tino7902/tablero-ajedrez-inteligente/software-docs/comandos.md

# Comandos: referencia rápida

Todos los comandos corren desde `tablero/` (ahí vive `pyproject.toml`), salvo que se
indique lo contrario. "Raspberry" significa por SSH, con el overlay `piscreen` activado
(ver [`pantalla.md`](./pantalla.md)); "notebook" significa cualquier máquina de
escritorio, sin hardware del tablero.

## Setup

```bash
cd tablero
uv sync              # instala/sincroniza dependencias en .venv
uv add <paquete>      # agrega una dependencia de runtime
uv add --dev <paquete> # agrega una dependencia de desarrollo (ej. pytest)
```

Corre en Raspberry o notebook por igual. Detalle de por qué `pygame` necesita
`uv sync --reinstall-package pygame` la primera vez en la Raspberry (compila desde fuente
contra el SDL2 del sistema): ver [`pantalla.md`](./pantalla.md#instalación-de-pygame).

## Tests

```bash
uv run pytest -v      # toda la suite
```

Corre en notebook o Raspberry. Solo `test_motor.py` necesita algo especial (el binario
`stockfish` en el `PATH`, y se saltea solo si no está); el resto —`test_logica.py`,
`test_eventos.py`, `test_reloj.py`, `test_notacion.py`, `test_partida.py`,
`test_registro.py`, `test_matriz.py`— no requiere nada. `test_sensores.py` está vacío todavía. Detalle
completo: [`testing.md`](./testing.md).

## Simulación de partida (terminal, sin hardware)

```bash
uv run python -m tablero.simulacion              # pregunta notación y minutos
uv run simulacion --notacion es --minutos 3      # sin preguntas
uv run simulacion --sin-registro                 # sin escribir en registros/
uv run simulacion --magnus facil --color negras  # contra Magnus, sin límite (necesita stockfish)
```

Corre en notebook o Raspberry, no toca `io/`. Se tipea un movimiento y el programa responde
si el tablero lo aceptaría o lo bloquearía, con el reloj corriendo y la regla de las dos
condiciones (movimiento legal + botón del reloj). Comandos completos y ejemplos:
[`simulacion.md`](./simulacion.md).

Cada partida queda registrada en `tablero/registros/` (PGN de las últimas 15, log detallado
de las últimas 5, ver [`registro.md`](./registro.md)):

```bash
cat tablero/registros/partidas/*.pgn      # PGN multi-partida, se abre en cualquier visor
cat tablero/registros/detalle/*.log       # qué intentó cada jugador, cuándo y con qué reloj
```

## Entry point del proyecto

```bash
uv run tablero               # ejecuta tablero:main
uv run python -m tablero     # forma alternativa, mismo resultado
```

## Scripts de `io/` (pantalla táctil)

Estos sí dependen de hardware o de un modo específico — ver la columna "Dónde corre".
**Regla del proyecto**: Claude Code nunca ejecuta nada de esto por su cuenta (ni siquiera
como "chequeo de sintaxis"), siempre le da a Tino el comando exacto para que lo corra él
(por SSH en la Raspberry, o localmente en su notebook para el modo ventana de `menus.py`).

| Comando | Qué hace | Dónde corre | Variables de entorno relevantes |
|---|---|---|---|
| `uv run python -m tablero.io.pantalla` | Corre `probar_boton()`: dibuja un botón de prueba y loguea cada evento de touch (`FINGERDOWN`/`MOUSEBUTTONDOWN`), aplicando calibración si existe. `Ctrl+C` para salir. | Pensado para Raspberry, pero también corre en notebook con la variable de abajo (útil para revisar el layout del botón con mouse). | `TABLERO_PANTALLA_VENTANA=1` — ver más abajo. |
| `uv run python -m tablero.io.calibracion_touch` | Corre `ejecutar_calibracion()`: muestra 5 cruces, pide tocarlas en orden, ajusta una transformación afín por mínimos cuadrados y la guarda en `calibracion_touch.json`. | Solo tiene sentido en la Raspberry — calibrar con mouse en una ventana da una transformación inútil (no hay touch real que corregir). | `TABLERO_PANTALLA_VENTANA=1` evita el crash de `kmsdrm not available` si se corre en notebook, pero no lo hace útil. |
| `uv run python -m tablero.io.menus` | Corre `ejecutar_menus()`: navega las 6 pantallas de menú/juego de los bocetos (ver [`menus.md`](./menus.md)), logueando cada botón tocado. `Ctrl+C` para salir. | Raspberry (comportamiento default) **o** notebook, con la variable de abajo — este es el caso de uso principal del modo ventana. | `TABLERO_PANTALLA_VENTANA=1` — ver más abajo. |

`TABLERO_PANTALLA_VENTANA=1`: evita que `io/_sdl.py` fuerce `SDL_VIDEODRIVER=kmsdrm` +
`SDL_NOMOUSE=1` (el backend que busca el panel físico vía DRM/KMS). Con la variable seteada,
`pygame` abre una ventana normal de escritorio de 480×320 y el mouse queda habilitado, en
vez de fallar con `pygame.error: kmsdrm not available` al no encontrar el dispositivo DRM
del panel. Sin la variable, los tres scripts se comportan como si corrieran en la
Raspberry. Detalle de por qué esto vive centralizado en `io/_sdl.py` y no repetido en cada
archivo: [`menus.md`](./menus.md#modo-ventana-testear-sin-la-raspberry).

Ejemplos completos:

```bash
# Por SSH, en la Raspberry:
cd tablero && uv run python -m tablero.io.menus

# En el notebook, sin la Raspberry, para iterar el diseño visual:
cd tablero && env TABLERO_PANTALLA_VENTANA=1 uv run python -m tablero.io.menus
```

## Scripts de `io/` (sensores y LEDs)

Solo corren en la Raspberry, por SSH, desde `tablero/`. Misma regla que arriba: Claude Code nunca
los ejecuta, le da a Tino el comando. Armado y prueba de la matriz:
`hardware-docs/matriz-hall-nano.md`; pruebas desde la Pi: "Cómo probarlo" en
[`sensores.md`](./sensores.md#matriz).

> **Matriz de sensores (v3).** `medir`, `matriz`, `calibrar` y `mapear` le piden cada lectura al
> Arduino Nano por USB serie: el Nano tiene que estar enchufado a la Pi con el firmware cargado, y
> el usuario en el grupo `dialout`. Cada comando tarda ~2 s en arrancar (abrir el puerto resetea
> el Nano). Primera vez, problemas de conexión y el puerto (`NANO_PUERTO`): "Cómo probarlo" en
> [`sensores.md`](./sensores.md#matriz).

| Comando | Qué hace | Detalle |
|---|---|---|
| `uv run python -m tablero.io.sensores` (o `... botones`) | Loguea cada presión de los botones del reloj | [`sensores.md`](./sensores.md) |
| `uv run python -m tablero.io.sensores medir F0` | Deja una fila fija para medir tensiones con el multímetro y muestra las columnas y su nivel (`ADC`) en vivo (también acepta una casilla: `medir e4`; la fila va con F mayúscula) | [`sensores.md`](./sensores.md#medir) |
| `uv run python -m tablero.io.sensores matriz` | Matriz cruda y tablero mapeado, en vivo | [`sensores.md`](./sensores.md#matriz-en-vivo) |
| `uv run python -m tablero.io.sensores calibrar` | Mide la espera de encendido de los Hall y el antirrebote, con los LEDs mostrando lo que detectan (sudo; `--sin-leds` sin ellos) | [`sensores.md`](./sensores.md#calibrar) |
| `uv run python -m tablero.io.sensores mapear` | Genera `CASILLA_DE_CELDA_HALL` (las 64 casillas) | [`sensores.md`](./sensores.md#mapear) |
| `uv run python -m tablero.io.leds todos` / `recorrer` / `esquinas` / `calibrar` / `verificar` | Pruebas de la tira de LEDs (se relanza con `sudo`) | [`leds.md`](./leds.md) |
| `uv run python -m tablero.io.prueba_tablero leds` / `recorrido` / `espejo` / `inicial` | Sensores y LEDs juntos: asociar LEDs, verificar las 64 casillas, espejo en vivo, posición inicial (se relanza con `sudo`) | [`prueba-tablero.md`](./prueba-tablero.md) |
| `uv run python -m tablero.io.juego` (`--minutos N`, `--fen FEN`, `--sin-leds`, `--sin-registro`, `-v`) | Partida en el tablero físico: matriz, botones del reloj y LEDs; la jugada cuenta al apretar el reloj (se relanza con `sudo`, salvo con `--sin-leds`) | [`juego.md`](./juego.md) |
| `uv run python -m tablero.io.juego --magnus {facil,medio,dificil}` (`--color {blancas,negras,aleatorio}`) | Lo mismo contra Magnus (Stockfish), sin límite de tiempo: su jugada la hacés vos en el tablero y la confirmás con cualquier botón. Necesita `stockfish` (`sudo apt install stockfish`) | [`juego.md`](./juego.md#contra-magnus---magnus) |
| `uv run python -m tablero.io.sensores_reed matriz` / `calibrar` | La versión anterior, con reed switches | [`sensores-reed.md`](./sensores-reed.md) |
| `uv run python -m tablero.io.menus_gpio` | La interfaz completa con los botones físicos del reloj | [`menus.md`](./menus.md) |

## Firmware del Arduino Nano

Desde la **raíz del repo** (no desde `tablero/`), en la notebook. Compilar sirve para chequear el
firmware sin el Nano, y Claude Code lo puede correr; subirlo y abrir el monitor necesitan el Nano
enchufado, así que los corre Tino. Detalle, protocolo y prueba con el Nano suelto en
[`firmware-nano.md`](./firmware-nano.md).

| Comando | Qué hace |
|---|---|
| `arduino-cli compile --fqbn arduino:avr:nano:cpu=atmega328 firmware/matriz-nano` | Compila el firmware (agregar `--build-property "compiler.cpp.extra_flags=-DPLAN_B=1"` para el plan B) |
| `arduino-cli compile --upload -p /dev/ttyUSB0 --fqbn arduino:avr:nano:cpu=atmega328 firmware/matriz-nano` | Compila y lo sube al Nano (si da `not in sync`, el Nano tiene el bootloader viejo: `cpu=atmega328old`) |
| `arduino-cli monitor -p /dev/ttyUSB0 -c baudrate=115200` | Monitor serie, para escribirle comandos (`?`, `L`, `F 0`, `C`, `X`, `A`, `V`) |
| `arduino-cli board list` | En qué puerto quedó el Nano (`/dev/ttyUSB0` en los clones con CH340, si no `/dev/ttyACM0`) |

## Ver también

- [`pantalla.md`](./pantalla.md) — overlay `piscreen`, instalación de `pygame`, calibración
  táctil.
- [`menus.md`](./menus.md) — grafo de navegación de `io/menus.py` y el modo ventana.
- [`testing.md`](./testing.md) — qué cubre cada archivo de test.
- [`simulacion.md`](./simulacion.md) — modo de prueba de la lógica por terminal.
- [`vs-magnus.md`](./vs-magnus.md) — el modo contra Stockfish.
- [`pendiente-pi.md`](./pendiente-pi.md) — lo que falta probar en la Pi y cómo.
- [`arranque-automatico.md`](./arranque-automatico.md) — el servicio de systemd que abre el
  menú al prender la Pi, y cómo pararlo para probar otra cosa por SSH.
- [`registro.md`](./registro.md) — dónde y cómo quedan registradas las partidas.
