tino7902/tablero-ajedrez-inteligente/software-docs/leds.md

# `io/leds.py`

Controla los 64 LEDs WS2812B del tablero, uno por casilla, con `rpi-ws281x`. Hasta el
2026-10-22 había además un LED de sacrificio al principio de la tira (ver
`hardware-docs/componentes.md`); ese día se quemó, la señal pasó a entrar directo al primer
LED de las casillas (el de h8) y el mapeo se corrió en −1. **Probado en el prototipo** (2026-10-18):
los 64 LEDs funcionan y `LED_DE_CASILLA` ya está generado con `prueba_tablero leds` (ver
[`prueba-tablero.md`](./prueba-tablero.md)). La tira se alimenta, por ahora, con un cargador de
celular que comparte con el Nano (ver `hardware-docs/componentes.md`).

## API

| Función/clase | Qué hace |
|---|---|
| `indice_de(casilla)` | Índice en la tira del LED de una `chess.Square`, según la tabla `LED_DE_CASILLA` |
| `TiraLeds(brillo)` | Inicializa la tira (`PixelStrip.begin()`) |
| `.encender(casilla, color)` / `.encender_indice(i, color)` | Fija el color de un LED (no se ve hasta `mostrar()`) |
| `.limpiar()` / `.mostrar()` / `.apagar()` | Todo en negro / enviar a la tira / las dos cosas |
| `formatear_led_de_casilla(tabla)` | Bloque `LED_DE_CASILLA` listo para pegar en `config.py`; lo usan `calibrar` y `prueba_tablero leds` |
| `ROJO`, `VERDE`, `AZUL`, `AMARILLO`, `BLANCO`, `APAGADO`, `BLANCO_TENUE`, `VIOLETA`, `CIAN` | Colores (`rpi_ws281x.Color`). Los últimos tres los usa `io/juego.py`: destinos posibles y la jugada de Magnus |

## Configuración (`config.py`)

| Constante | Valor | Nota |
|---|---|---|
| `LED_GPIO_BCM` | 12 | Pin físico 32. `rpi-ws281x` usa numeración **BCM**, no BOARD como `io/sensores.py` |
| `LED_CANAL_PWM` | 0 | GPIO 12 es PWM0 |
| `LED_CANTIDAD` | 64 | 65 si se vuelve a poner un LED de sacrificio |
| `LED_INDICE_SACRIFICIO` | `None` | Sin LED de sacrificio. Con uno (índice 0), `mostrar()` lo fuerza a negro antes de enviar |
| `LED_BRILLO` | 32 | Brillo global, de 0 a `LED_BRILLO_MAX` |
| `LED_BRILLO_MAX` | 191 | Tope del brillo (75 %): `TiraLeds` lo aplica aunque `--brillo` pida más, y avisa por el log |
| `LED_DE_CASILLA` | Generado el 2026-10-22 y espejado (a↔h): serpentina por columnas desde h8; corrido en −1 al sacar el LED de sacrificio | Tabla de 64 índices (`[chess.Square]`); se regenera con `calibrar` o `prueba_tablero leds` |

## Decisiones de diseño

- **Mapeo casilla → LED por tabla, no por fórmula**: `LED_DE_CASILLA[casilla]` da el índice
  en la tira, igual que las permutaciones de `io/sensores.py` para la matriz. Así no importa
  cómo se haya soldado la tira (serpentina, filas en el mismo sentido, arrancando en h8...) ni
  si algún tramo quedó salteado: se mide con `calibrar` y se pega el resultado. El valor por
  defecto supone serpentina desde a1 justo después del LED de sacrificio.
- **Brillo bajo por defecto y con tope**: 64 LEDs en blanco al 100 % consumen ~3,8 A, en el
  límite de la fuente de 5 V >4 A. Para las pruebas alcanza con 32; `--brillo` permite
  subirlo hasta `LED_BRILLO_MAX` (75 %). El tope está en `TiraLeds`, así vale para todos los
  programas. Al 75 %, el peor caso (`leds todos` en blanco) es ~2,9 A. En `juego`, en uso
  normal, lo más que se prende es la posición inicial en verde o en rojo (32 casillas de un
  solo color, ~0,5 A).
- **LED de sacrificio siempre apagado**: su único trabajo es regenerar la señal de datos a
  nivel de 5 V para el resto de la tira (alimentado a ~4,3 V por el 1N4007), así que no importa
  qué color muestre. **Sin él** (desde el 2026-10-22) los 3,3 V de GPIO 12 entran directo a un
  WS2812B alimentado a 5 V, que pide ≥ 0,7 × 5 V = 3,5 V para leer un 1: suele andar igual,
  pero queda al límite. Si la tira parpadea o muestra colores al azar, la solución es volver a
  poner un LED de sacrificio (con su 1N4007) o un adaptador de nivel (74AHCT125).

## Requisitos en la Raspberry

- **Root**: `rpi-ws281x` accede a `/dev/mem`. Se corre como el resto del proyecto,
  `uv run python -m tablero.io.leds ...` desde `tablero/`: si el proceso no es root, el
  `__main__` de `io/leds.py` se relanza con `sudo <python del .venv> -m tablero.io.leds ...`
  (en Raspberry Pi OS el usuario principal tiene sudo sin contraseña). No usar
  `sudo uv run`, que corre con el entorno de root y puede dejar archivos de root en el
  `.venv`. Un programa que importe `TiraLeds` tiene que arrancar como root o relanzarse igual
  (es lo que hacen `io/prueba_tablero.py` e `io/juego.py`).
- **Audio analógico desactivado**: el PWM de los LEDs es el mismo que el del audio. En
  `/boot/firmware/config.txt` (o `/boot/config.txt` en sistemas viejos) poner
  `dtparam=audio=off` y reiniciar. Sin esto, los LEDs parpadean con colores al azar o no
  responden.
- **GND común** entre la fuente de 5 V de los LEDs y la Raspberry.

## Cómo probarlo

Desde `tablero/`, por SSH en la Raspberry:

```bash
uv run python -m tablero.io.leds todos      # 64 casillas en rojo, verde, azul y blanco
uv run python -m tablero.io.leds recorrer   # un LED por vez, Enter para el siguiente
uv run python -m tablero.io.leds esquinas   # a1 rojo, h1 verde, a8 azul, h8 amarillo
uv run python -m tablero.io.leds calibrar   # genera LED_DE_CASILLA
uv run python -m tablero.io.leds verificar  # recorre a1, b1, ..., h8 con el mapeo
```

Orden recomendado: `todos` (¿prenden todos? ¿colores correctos, o rojo y verde invertidos?
Eso sería `strip_type` GRB/RGB), después `calibrar` y por último `verificar`/`esquinas` para
confirmar el mapeo. `Ctrl+C` apaga la tira y sale.

**Con los sensores Hall ya mapeados**, en vez de `calibrar` conviene
`uv run python -m tablero.io.prueba_tablero leds`: prende cada LED y la casilla la dicen los Hall
al poner una pieza en la casilla iluminada, sin tipear nada. Después,
`prueba_tablero recorrido` verifica LEDs y sensores juntos. Ver [`prueba-tablero.md`](./prueba-tablero.md).

### `calibrar`

Prende cada LED (1..64) en blanco y pregunta en qué casilla se ve. Se responde con el nombre
(`e4`), `-` si ese LED no cae en ninguna casilla, o `r` para volver al LED anterior si hubo un
error. No deja asignar dos LEDs a la misma casilla. Al final imprime la tupla
`LED_DE_CASILLA` lista para pegar en `config.py`, una fila de ajedrez por línea.
