tino7902/tablero-ajedrez-inteligente/hardware-docs/matriz-hall-nano.html

Tablero de ajedrez · guía de armado · hardware

# Matriz Hall con Arduino Nano

Guía para armar la detección de casillas: 64 sensores Hall A3144 en una matriz de 8 × 8, leídos por un Arduino Nano que le pasa el estado del tablero a la Raspberry Pi por USB. Un NPN por fila maneja la corriente. Reemplaza al 74HC138 y al 74HC165. Las 64 celdas ya están soldadas; esta guía cubre todo lo demás.

## Por qué se cambia

1,6 Vdaba la salida activa del 138 (tenía que ser < 0,3 V)

~200 mApuede pasar por una fila llena de piezas con las celdas como están soldadas

≈ 9 mApone un pin del Nano en la base del NPN de la fila (con 470 Ω)

5 Valimentan los Hall, en vez de 3,3 V

El 138 no podía hundir la corriente de una fila. Con el Nano, cada fila tiene un transistor que la maneja y los Hall se alimentan a 5 V. Ningún pin de la Raspberry queda conectado a la matriz: la Pi solo ve el Nano por USB.

## Materiales

Componente | Cantidad | Detalle
Arduino Nano (ATmega328P) | 1 | Original o clon. Con su cable USB (mini-USB o USB-C, según el modelo).
Transistor NPN | 8 | Uno por fila. BC337, 2N2222 o S8050. No BC547, BC548 ni 2N3904: no aguantan la corriente (ver Transistores).
Resistencia 470 Ω | 8 | Base de cada NPN.
Resistencia 10 kΩ | 8 | Entre base y GND de cada NPN (lo mantiene apagado).
Sensor Hall A3144 + diodo | 64 | Ya soldados, uno por casilla, con el diodo en el GND (ver Una celda).
Placa perforada, cable, tira de pines o zócalo para el Nano | — | Conviene montar el Nano en zócalo o tira hembra para poder sacarlo.

Salen de la placa: el 74HC138, el 74HC165 y las 8 resistencias pull-up de 10 kΩ que iban a 3,3 V. Las columnas usan las pull-ups internas del Nano.

## Esquema general

Cómo funciona: el Nano enciende una fila por vez (pone su pin en HIGH), espera 1 ms a que los Hall arranquen, lee las 8 columnas y pasa a la siguiente. Una columna en LOW es un imán sobre esa casilla. Hace ese recorrido cada vez que la Pi se lo pide (muchas veces por segundo) y le contesta la matriz por el puerto serie.

### La matriz, cable por cable

Cada punto es un Hall. Su GND llega al bus de su fila (negro) a través de un diodo; su salida va directo al cable de su columna (azul). El Vcc de los 64 Hall va al riel de 5 V (no dibujado en la grilla).

## Una fila: el driver NPN

Hay 8 iguales, uno por fila. Se pueden armar juntos en un costado de la placa, cerca del Nano.

Estado | Pin del Nano | NPN | Bus de la fila
Fila elegida | HIGH (5 V) | conduce (≈ 9 mA de base) | ≈ 0,1–0,3 V: fila encendida
Fila no elegida | LOW (0 V) | cortado | flota: fila apagada

- Por qué hasta ~200 mA: los 8 Hall de la fila consumen ~35 mA. Además, cada Hall que detecta una pieza recibe ~20 mA de los otros 7 Hall de su columna (ver Una celda), y esa corriente también baja por el NPN. Con la fila llena de piezas, como en la posición inicial, son 35 + 8 × 20 ≈ 200 mA.
- La resistencia de 470 Ω deja pasar ~9 mA del pin del Nano (su máximo recomendado es 20 mA), lo justo para saturar el NPN con 200 mA. Sin ella se quema el pin o el transistor.
- La de 10 kΩ deja el NPN apagado mientras el Nano arranca o si se desconecta.
- El emisor y la de 10 kΩ van al GND del Nano. Todos los GND del circuito son el mismo.

## Una celda: así están soldadas

Las 64 celdas ya están armadas así y no se cambian. El diodo está en el GND de cada Hall, y la salida va directo a la columna.

### Qué implica este armado

Efecto | Valor | Consecuencia
El diodo suma ~0,6–0,8 V en el GND de cada Hall | 4,3 V · 3,9 V con fila llena | Tensión de alimentación de cada Hall, por debajo de los 4,5 V que pide la hoja de datos del A3144 original. Los clones que se venden hoy suelen funcionar igual: hay que comprobarlo en la prueba.
Los otros 7 Hall de la columna le pasan corriente al que detecta | ~20 mA | En las filas apagadas, el GND de cada Hall flota y su consumo sale por un diodo interno hacia su salida, que está unida a la columna. Está dentro de lo que aguanta la salida del A3144 (~25 mA), pero obliga a usar un NPN más fuerte.
Nivel bajo de la columna con pieza | ~1,1–1,3 V | El Nano tiene garantizado leer LOW hasta 1,5 V. Si queda más alto, pasar al plan B.
Piezas fantasma | no hay | El diodo del GND impide que un Hall de una fila apagada encuentre camino a GND, así que no puede bajar la columna.

Sensor | Patas
A3144 (TO-92) | Mirando la cara plana con letras, patas hacia abajo, de izquierda a derecha: 1 Vcc · 2 GND · 3 OUT.

- Polaridad: el A3144 solo detecta el polo sur de un imán puesto contra su cara con letras. Esa cara va hacia arriba y todos los imanes, con el sur hacia abajo.
- No puentear el diodo del GND: sin él, las filas apagadas bajarían las columnas y aparecerían piezas fantasma.

## Tabla de conexiones

Cada fila y cada columna conserva el número que tenía con el 138 y el 165: el cable que iba a la salida Yk del 138 ahora es la fila Fk, y el que iba a la entrada Dk del 165 ahora es la columna Ck. Así el mapeo de casillas que ya está en el software (CASILLA_DE_CELDA_HALL) sigue valiendo. Respetar este orden.

Fila | Pin del Nano | Va a | Antes iba a

Columna | Pin del Nano | Va a | Antes iba a

Otros pines del Nano | Conexión
5V | Riel de Vcc de los 64 Hall.
GND | Emisores de los 8 NPN y las 8 resistencias de 10 kΩ de base. Cualquiera de los dos pines GND del Nano.
USB | A un puerto USB de la Raspberry Pi. Alimenta el Nano y transmite los datos.
D13, A5 | Libres. D13 tiene el LED de la placa: no usarlo como entrada. A5 se usa en el plan B.
A6, A7 | Libres (solo analógicos). Se usan en el plan B.
D0, D1 | No conectar. Los usa el USB.
VIN, 3V3, RST, AREF | No conectar.

## Transistores

Por cada fila pueden pasar hasta ~200 mA, así que el NPN tiene que aguantar bastante más que eso. El orden de las patas también cambia según el modelo.

Modelo | Corriente máxima | ¿Sirve? | Patas (cara plana al frente, patas abajo, de izq. a der.)
BC337 | 800 mA | Sí | C · B · E
2N2222A (TO-92) | 600 mA | Sí | E · B · C
S8050 | 500 mA o más | Sí | E · B · C
BC547, BC548 | 100 mA | No | —
2N3904 | 200 mA | No: queda al límite | —

Medir siempre antes de soldar, aunque el modelo esté en la tabla (hay clones con otro orden). Multímetro en modo diodo:

1. Buscá la pata que, con la punta roja en ella, marca ~0,6–0,7 V contra cada una de las otras dos. Esa es la base (B). Si eso pasa con la punta negra, el transistor es PNP y no sirve.
2. De las otras dos, la que marca un poco más (unas centésimas) es el emisor (E); la otra es el colector (C).
3. Si el multímetro tiene zócalo hFE, confirmalo: puesto bien, marca entre 100 y 500.

## Pasos de armado

1. Desconectar la matriz de la Raspberry. Sacar todos los cables entre la placa de la matriz y los pines 29, 31, 36, 37, 38 y 40 de la Pi, y el cable de 3,3 V que alimentaba los Hall. Al terminar, la Pi solo se conecta al Nano por USB.
2. Sacar el 138, el 165 y sus 8 pull-ups de 10 kΩ. Marcar antes cada cable de fila con su número (el de la Y del 138, F0–F7) y cada cable de columna con el suyo (el de la D del 165, C0–C7). Ver Tabla de conexiones para saber qué pata era cuál.
3. Pasar el riel de Vcc de los Hall a 5 V. El riel que unía los Vcc de los 64 Hall ahora va al pin 5V del Nano. Nada del circuito queda conectado a 3,3 V.
4. Armar los 8 drivers NPN según Una fila: 470 Ω del pin del Nano a la base, 10 kΩ de la base a GND, emisor a GND. Usar BC337, 2N2222 o S8050, y medir las patas de cada uno antes de soldarlo.
5. Conectar cada bus de fila al colector de su NPN. El bus que iba a la pata Yk del 138 va al colector del NPN de Fk.
6. Montar el Nano, mejor en zócalo o tira hembra. Conectar las resistencias de 470 Ω a D2–D9 (F0–F7) y los cables de columna a D10, D11, D12, A0, A1, A2, A3 y A4 (C0–C7).
7. Unir los GND: emisores de los NPN y resistencias de 10 kΩ al GND del Nano.
8. Verificar sin alimentar (siguiente sección) antes de enchufar el USB.

### No hacer

- No conectar los Hall ni las columnas a ningún pin de la Raspberry Pi. Los 5 V de la matriz pueden quemar la Pi.
- No usar BC547, BC548 ni 2N3904: se queman con la fila llena de piezas.
- No conectar una base de NPN directo a un pin del Nano sin su resistencia de 470 Ω.
- No agregar pull-ups externas en las columnas: le suman corriente al Hall que detecta. Alcanzan las internas del Nano.
- No alimentar los Hall con más de 5 V: sus salidas van directo a los pines del Nano.
- No usar D0 ni D1.
- No conectar el bus de una fila directo a GND: tiene que pasar por el NPN, o esa fila queda siempre encendida.
- No alimentar el Nano por VIN mientras está conectado por USB.

## Verificación sin alimentar

Con el USB desenchufado, multímetro en continuidad o en modo diodo. Las casillas se pueden tildar mientras se mide; quedan guardadas en este navegador.

- Ningún cable de la matriz va a la Raspberry Pi (solo el USB al Nano).
- Vcc de cada Hall ↔ pin 5V del Nano: continuidad.
- Modo diodo, punta roja en el GND de un Hall, negra en el colector del NPN de su fila: ~0,5–0,7 V. Así se prueba el diodo de cada celda. OL = diodo cortado o al revés; ~0 V = diodo en corto.
- Las mismas puntas invertidas: OL. Si marca ~0,5 V, ese diodo está al revés.
- GND de cada Hall ↔ GND del Nano: sin continuidad. Si hay, ese Hall está a GND directo.
- OUT de cada Hall ↔ el pin del Nano de su columna: continuidad.
- Cada columna ↔ las otras columnas, y cada columna ↔ GND: sin continuidad.
- Cada colector de NPN ↔ los colectores de las otras filas: sin continuidad (buses de fila separados).
- Emisor de cada NPN ↔ GND del Nano: continuidad.
- Cada pin D2–D9 ↔ base de su NPN: ~470 Ω en resistencia.
- Base de cada NPN ↔ GND: ~10 kΩ en resistencia (algo menos, porque mide en paralelo con el transistor).
- 5V ↔ GND del Nano: sin corto (no tiene que pitar).

## Prueba con alimentación

Primero con un solo driver armado (fila F0, en D2), antes de soldar los otros 7. La medición que decide si el plan sirve es la de la fila llena de piezas.

Se usa el firmware definitivo del Nano, que también sirve para probar: se le escriben comandos desde el monitor serie y contesta una línea. Está en el repo del proyecto, en firmware/matriz-nano/; cómo subirlo y la lista completa de comandos, en software-docs/firmware-nano.md. Si no tenés el repo, pedile al equipo de software el Nano ya cargado.

Comando | Qué hace
V | Muestra la grilla en vivo cada medio segundo: una línea por fila (F0…F7), un carácter por columna (C0…C7), # = imán. Escribir cualquier cosa la corta.
F 0 | Deja F0 encendida fija, para medir con el multímetro (barriendo, cada fila está encendida 1/8 del tiempo y el multímetro marca un promedio).
X | Apaga todas las filas.
A | Con una fila fija: el nivel de las columnas C3–C7, de 0 (0 V) a 1023 (~5 V). Por debajo de 307 el Nano lee el imán sin dudar. C0–C2 salen como - porque sus pines no miden tensión: esas, con el multímetro.
C | Con una fila fija: qué columnas ven imán, en hexadecimal (C FF = las 8).

1. Abrir el monitor serie a 115200 baudios (en el Arduino IDE, con fin de línea "Nueva línea"). Tiene que aparecer LISTO matriz-nano 1; si no aparece, escribir ? y Enter.
2. Probar con un imán. Escribir V. Al poner el polo sur sobre una casilla de F0, tiene que aparecer un # en la línea de F0, en la columna de esa casilla. Las otras filas (todavía sin driver) quedan en .........

   01234567
F0 ...#....
F1 ........
F2 ........
F3 ........
F4 ........
F5 ........
F6 ........
F7 ........
  Así se ve con un imán sobre la casilla F0 / C3. La primera línea numera las columnas.
3. Llenar F0 con 8 piezas y escribir F 0: F0 queda encendida hasta el próximo comando.
4. Hacer las mediciones de la tabla, con el multímetro y con A y C.

Medición con F0 llena (punta negra en GND del Nano) | Tiene que dar | Si no
Pin D2 | ≈ 5 V | No se escribió F 0, el firmware no está cargado o D2 está en corto.
Base del NPN de F0 | ≈ 0,7–0,9 V | 0 V: falta la de 470 Ω. ~5 V: transistor mal puesto o quemado.
Colector del NPN de F0 (bus de la fila) | < 0,3 V | El transistor no se satura: revisar el modelo, las patas y la de 470 Ω.
Entre GND y Vcc de un Hall de F0 (negra en su GND, roja en su Vcc) | ≥ 3,8 V | Riel de 5 V mal o el colector no baja. Si da bien pero no detecta, ese Hall no arranca con esa tensión.
Una columna de F0, con pieza (o A, C3–C7) | < 1,3 V A: < 270 | Entre 1,3 y 1,5 V (A: 270–307): funciona pero justo. Más de 1,5 V (A: más de 307): pasar al plan B.
La misma columna, sin pieza | ≈ 5 V A: ≈ 1020 | Columna en corto a GND o Hall dañado.
C | C FF | Ver Problemas.

Después, X y V: tiene que aparecer F0 ######## y las otras filas en ......... Si todo da bien, armar los otros 7 drivers y repetir con cada fila llena (F 1, F 2, …).

## Plan B: leer las columnas como analógicas

Solo si la columna con pieza queda por encima de ~1,3 V. Con analogRead, el umbral lo elige el firmware (por defecto 2,5 V) en vez de depender del umbral de la entrada digital del Nano.

- Recablear solo 3 columnas: C0 de D10 a A5, C1 de D11 a A6, C2 de D12 a A7. C3–C7 quedan en A0–A4.
- Agregar una pull-up de 10 kΩ a 5 V en A6 y en A7: esos dos pines no tienen pull-up interna. Las demás columnas siguen con la interna.
- Volver a subir el firmware compilado con PLAN_B=1 (el comando está en software-docs/firmware-nano.md; con el Arduino IDE, cambiar #define PLAN_B 0 por 1 al principio del sketch). No hay que tocar nada más del código, y los comandos siguen siendo los mismos.
- Ajustar el umbral si hace falta. Por defecto es 512 (~2,5 V). Llenar una fila, F k y A: con el plan B mide las 8 columnas. El umbral va entre el valor más alto de las columnas con pieza y el más bajo de las vacías.
- El barrido baja a unas 40 lecturas del tablero por segundo, que alcanza de sobra.

## Problemas frecuentes

Síntoma en el monitor serie (con V) | Causa probable
Una fila entera siempre en ######## | El bus de esa fila toca GND directo (sin pasar por el NPN), o el NPN está en corto.
Una columna entera siempre en # | El cable de columna toca GND.
Una fila nunca detecta | NPN con las patas cambiadas, falta la de 470 Ω, o el bus de fila no llega al colector.
Una casilla nunca detecta | Diodo del GND cortado o al revés, Hall de cara (letras abajo), imán con el norte abajo, o ese Hall no arranca con ~4 V.
Una pieza aparece también en otra fila | El diodo de algún Hall de esa columna está en corto o puenteado.
Con una pieza sola detecta, con la fila llena falla | El NPN no se satura (modelo débil o resistencia de base mayor a 470 Ω), o el nivel bajo de la columna supera el umbral: pasar al plan B.
Casillas que parpadean | Imán débil o lejos del sensor, o la columna con pieza queda cerca de 1,5 V: pasar al plan B.
Todo en ........ | Falta el 5 V en el riel de Vcc, o la unión de GND entre los emisores y el Nano.
No aparece nada en el monitor serie | Velocidad distinta de 115200, puerto equivocado, o el clon necesita el driver CH340.
No aparece LISTO matriz-nano 1 al abrir el monitor | Escribir ?. Si contesta, el monitor se abrió después del arranque; si no, el firmware no está cargado.
ERR comando o ERR argumento | El comando se escribió mal (por ejemplo F 8: las filas van de 0 a 7).

## Del lado del software

El firmware del Nano ya está escrito: es el mismo que se usa en la prueba, y en la partida le pasa la matriz a la Pi por USB cuando ella se la pide. Del lado de la Pi ya está escrito el programa que lo lee del puerto serie (falta probarlo con el Nano enchufado a la Pi); no cambia nada del armado.
