tino7902/tablero-ajedrez-inteligente/diseño-docs/diseño-interfaz.md

## Bocetos de la Interfaz del Tablero de Ajedrez Inteligente 'Magnus'

### Menú Principal

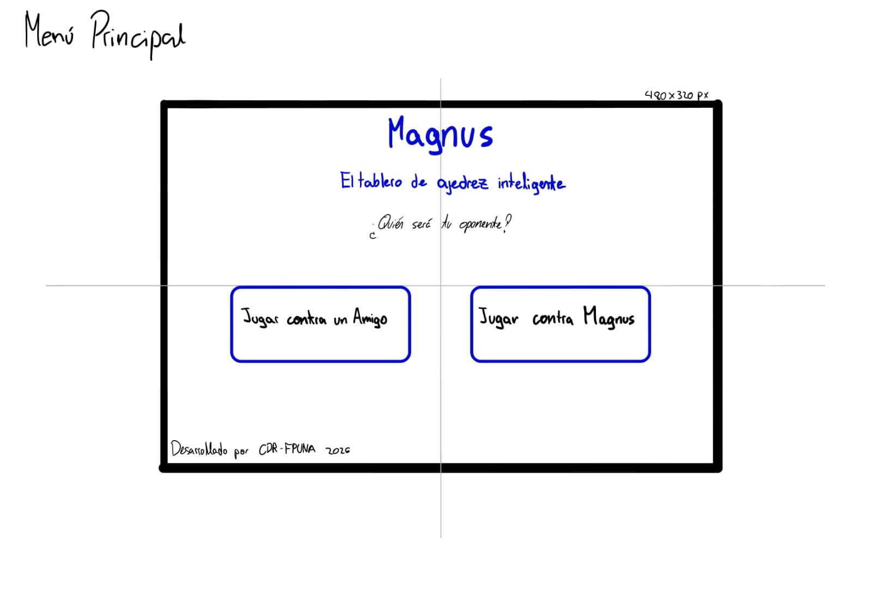
[picture p1: diseño-docs/img/menu-principal.jpeg]
boceto del menú principal


### Selector de Tiempo - Caso Jugador vs. Jugador

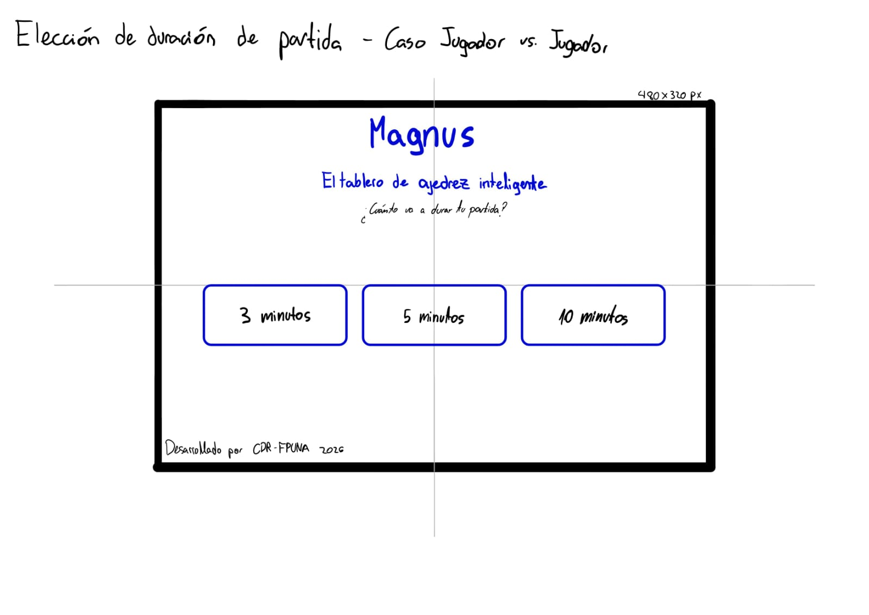
[picture p2: diseño-docs/img/selector-tiempo.jpeg]
boceto del selector de tiempo


### Selector de Dificultad - Caso Jugador vs. Magnus

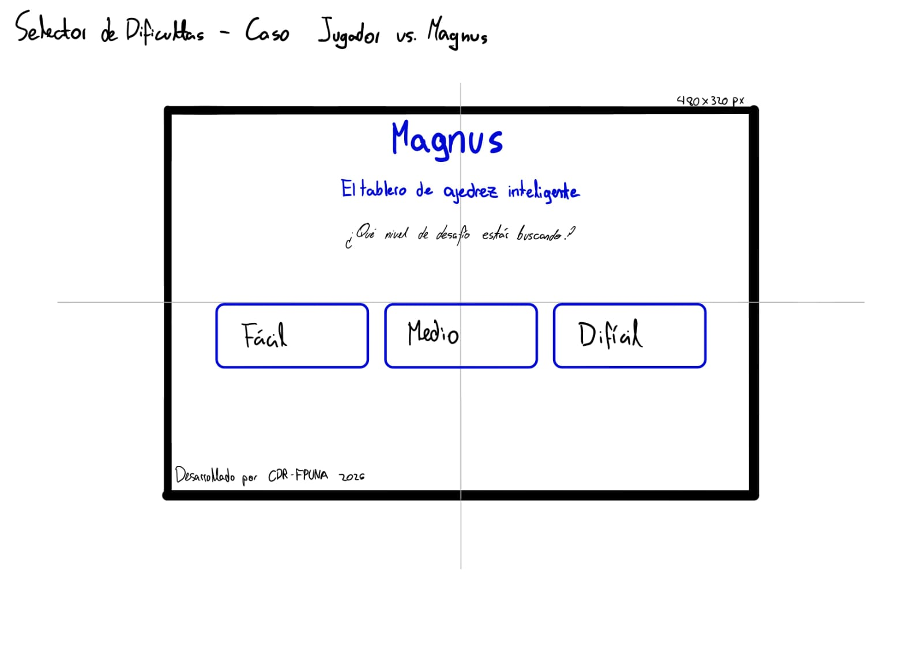
[picture p3: diseño-docs/img/selector-dificultad.jpeg]
boceto del selector de dificultad


### Interfaz de Juego - Caso Jugador vs. Jugador

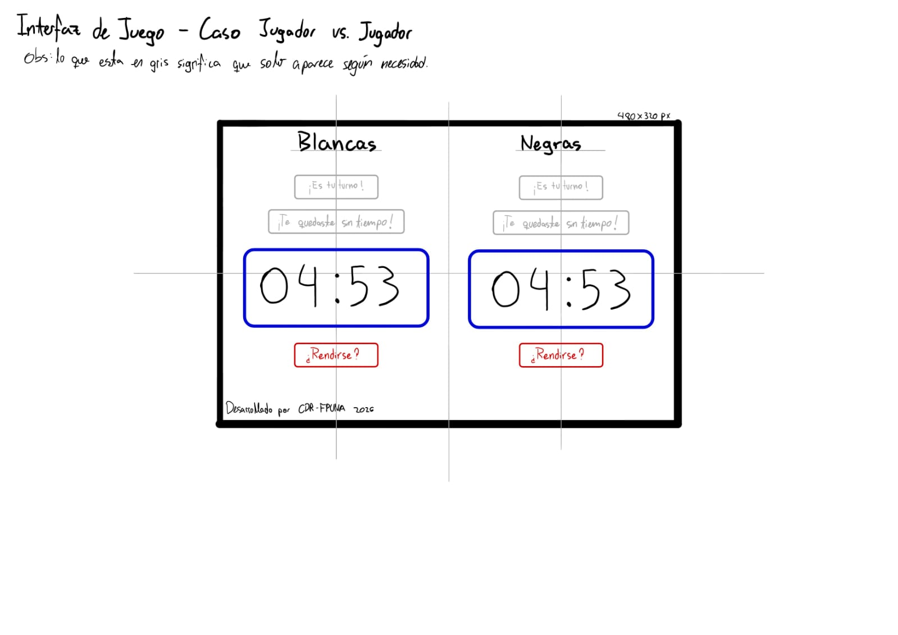
[picture p4: diseño-docs/img/interfaz-pvp.jpeg]
boceto de la interfaz de juego PvP


### Selector de Color - Caso Jugador vs. Magnus

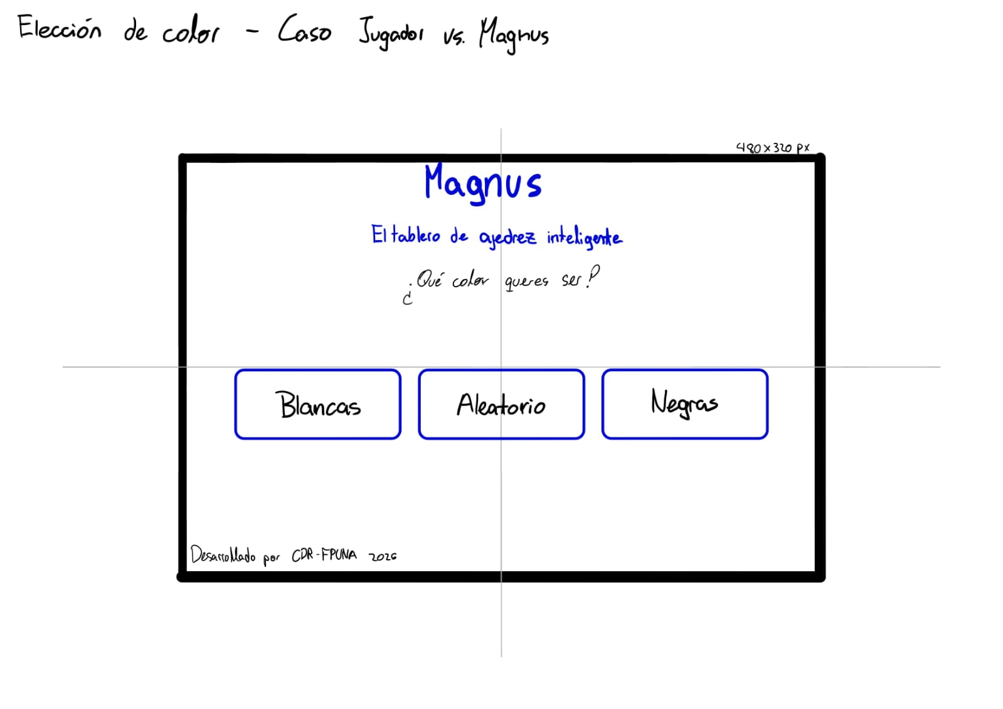
[picture p5: diseño-docs/img/color-pieza.jpeg]
boceto de la interfaz para elegir color de piezas vs. Magnus


### Interfaz de Juego - Caso vs. Magnus

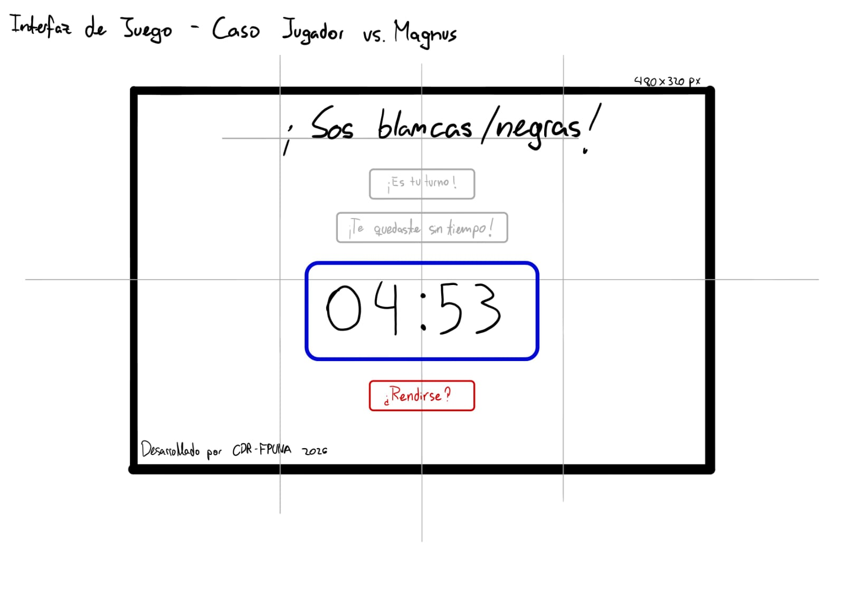
[picture p6: diseño-docs/img/interfaz-vs-magnus.jpeg]
boceto de la interfaz de juego vs. Magnus
