tino7902/tablero-ajedrez-inteligente/hardware-docs/circuito-deteccion-casillas-detalle-1.jpeg

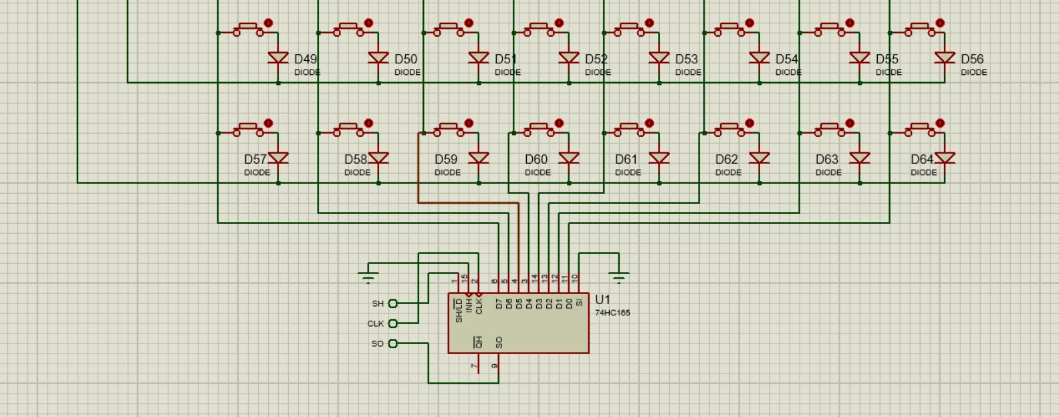
hardware-docs/circuito-deteccion-casillas-detalle-1.jpeg
