tino7902/tablero-ajedrez-inteligente/hardware-docs/circuito-deteccion-casillas-detalle-2.jpeg

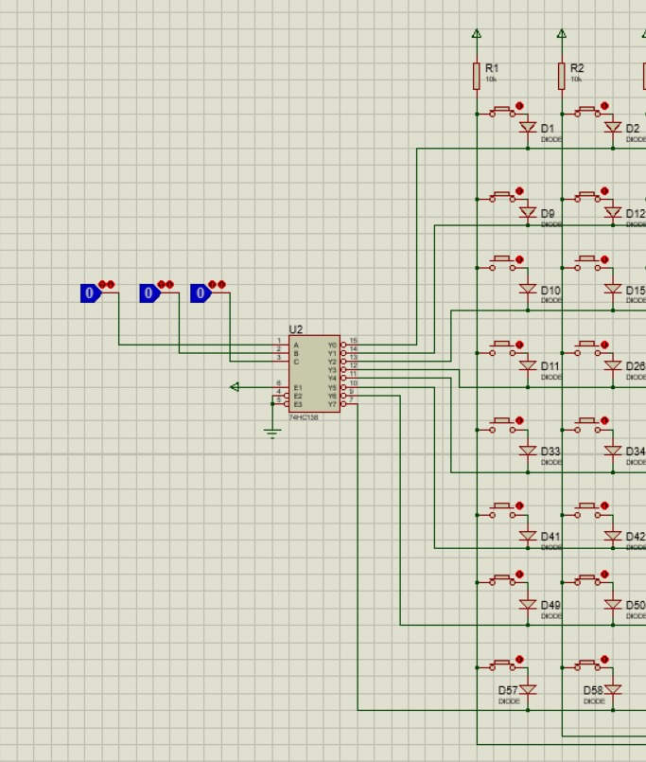
hardware-docs/circuito-deteccion-casillas-detalle-2.jpeg
