tino7902/tablero-ajedrez-inteligente/hardware-docs/circuito-deteccion-casillas.jpeg

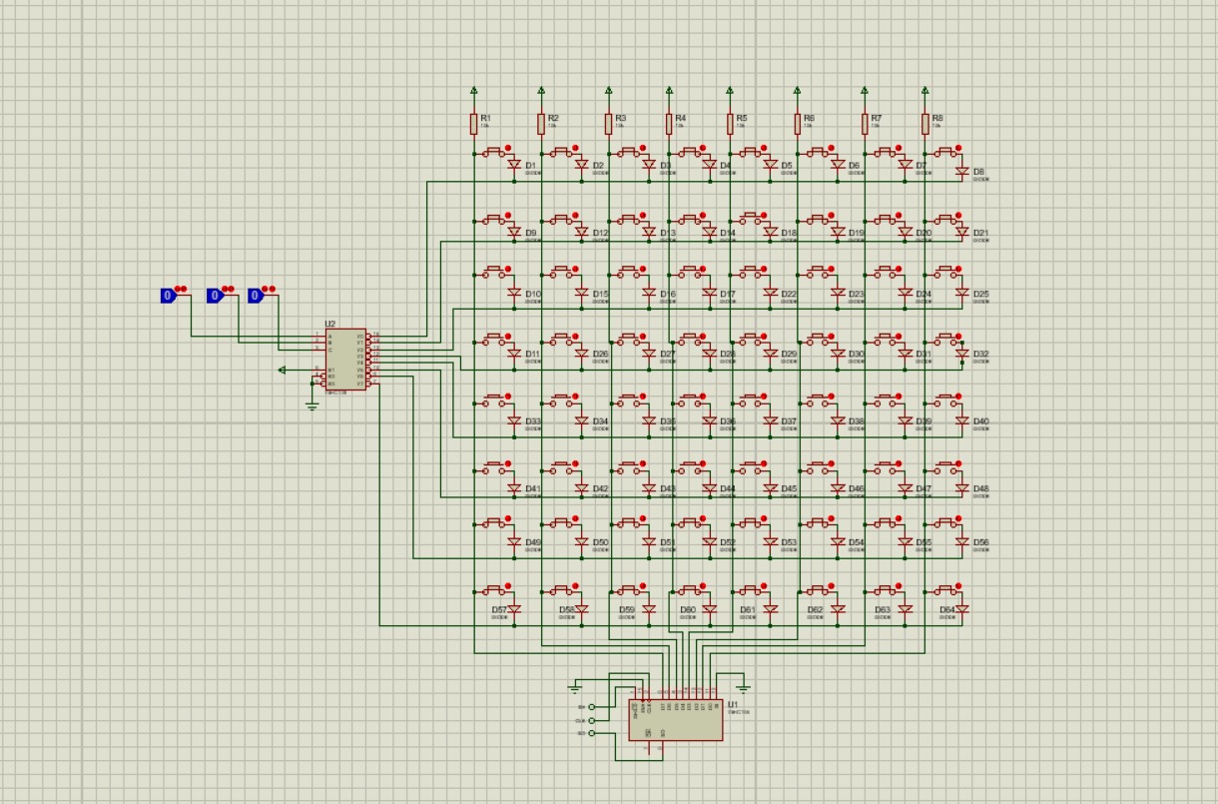
hardware-docs/circuito-deteccion-casillas.jpeg
