tino7902/tablero-ajedrez-inteligente/hardware-docs/pin_layout.jpeg

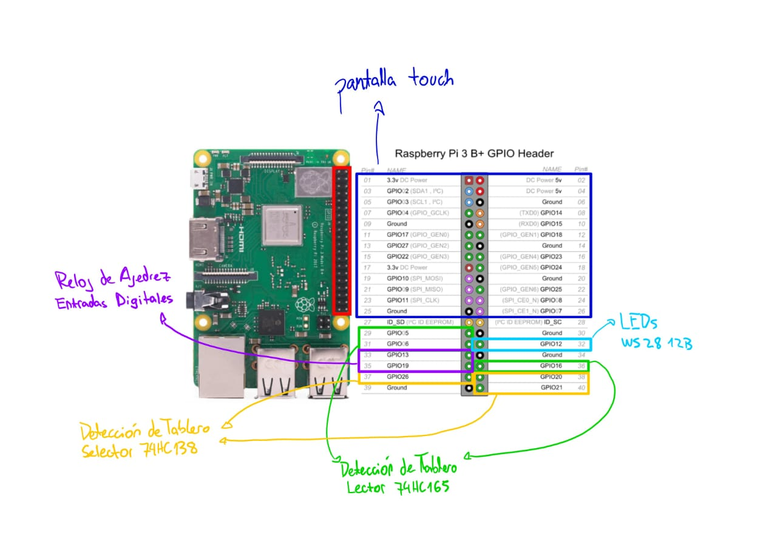
hardware-docs/pin_layout.jpeg
