tino7902/tablero-ajedrez-inteligente/tablero/src/tablero/io/sensores.py

"""Entradas digitales del tablero: botones del reloj y matriz de casillas con sensores Hall.

- Botones del reloj: dos interruptores fin de carrera, detectados por flanco
  (ver hardware-docs/componentes.md, sección "Asignación de Pines GPIO").
- Matriz de ocupación: 64 sensores Hall A3144 / KY-003 que barre un Arduino Nano (un NPN
  por fila, que enciende los Hall de esa fila) y que la Pi le pide por USB serie. El
  diálogo con el Nano vive en io/matriz.py, común con la versión anterior de reed switches
  (io/sensores_reed.py); cableado en hardware-docs/matriz-hall-nano.md.

Pruebas manuales en la Raspberry (ver software-docs/sensores.md):

    uv run python -m tablero.io.sensores botones
    uv run python -m tablero.io.sensores medir F0      (o una casilla: medir e4)
    uv run python -m tablero.io.sensores matriz
    uv run python -m tablero.io.sensores calibrar      (con los LEDs; sin ellos: calibrar --sin-leds)
    uv run python -m tablero.io.sensores mapear
"""

import argparse
import functools
import logging
import os
import sys
import time
from collections.abc import Callable

import chess
from RPi import GPIO  # pyright: ignore[reportMissingModuleSource] (solo en la Pi)

from tablero import config
from tablero.io import matriz
from tablero.io.matriz import configurar_matriz, leer_matriz, liberar_matriz
from tablero.logica import matriz as logica_matriz
from tablero.logica.matriz import Celda, MatrizCruda, celdas_activas

logger = logging.getLogger(__name__)

_NOMBRES_BOTONES = {
    config.PIN_BOTON_RELOJ_JUGADOR_1: "boton_1",
    config.PIN_BOTON_RELOJ_JUGADOR_2: "boton_2",
}


# -- Botones del reloj -------------------------------------------------------------


def configurar_botones_reloj(callback: Callable[[str], None]) -> None:
    """Configura GPIO para llamar a `callback('boton_1' | 'boton_2')` en cada presión.

    Los botones conectan el pin a GND al presionarse (activo en bajo), así
    que se habilita el pull-up interno del SoC (`GPIO.PUD_UP`) sin importar
    cómo estén armadas las resistencias externas (ver software-docs/sensores.md)
    y se detecta la presión por flanco descendente (`GPIO.FALLING`).

    El callback corre en el thread interno de `rpi-lgpio` (no en el thread que
    llama a esta función) — quien lo use debe tenerlo en cuenta si no es
    thread-safe. Llamar a `liberar_botones_reloj()` al terminar.
    """
    def _en_flanco(pin: int) -> None:
        callback(_NOMBRES_BOTONES[pin])

    GPIO.setmode(GPIO.BOARD)
    for pin in _NOMBRES_BOTONES:
        GPIO.setup(pin, GPIO.IN, pull_up_down=GPIO.PUD_UP)
        GPIO.add_event_detect(pin, GPIO.FALLING, callback=_en_flanco, bouncetime=200)


def liberar_botones_reloj() -> None:
    """Libera solo los pines de los botones, para no desarmar la matriz si está en uso."""
    for pin in _NOMBRES_BOTONES:
        GPIO.remove_event_detect(pin)
    GPIO.cleanup(list(_NOMBRES_BOTONES))


def probar_botones_reloj() -> None:
    """Loguea cada vez que se presiona alguno de los dos botones del reloj.

    Test manual de hardware standalone, construido sobre `configurar_botones_reloj()`.
    Todavía no hay lógica de reloj acá (eso vive en `io/menus.py`/`io/menus_gpio.py`) —
    solo confirma que la detección de flanco funciona en cada pin por separado. Corre
    indefinidamente hasta Ctrl+C.
    """
    configurar_botones_reloj(lambda nombre: logger.info("%s presionado", nombre))
    logger.info(
        "Esperando presiones en boton_1 (pin %d) o boton_2 (pin %d) (Ctrl+C para salir)...",
        config.PIN_BOTON_RELOJ_JUGADOR_1,
        config.PIN_BOTON_RELOJ_JUGADOR_2,
    )
    try:
        while True:
            time.sleep(1)
    except KeyboardInterrupt:
        pass
    finally:
        liberar_botones_reloj()
        logger.info("GPIO liberado, saliendo.")


# -- Matriz de casillas (sensores Hall) ----------------------------------------------

_LEYENDA = "Hall activo"

# Esperas por fila que prueba `calibrar`, de la más larga a la más corta (segundos).
# La más larga es la referencia: con 5 ms cualquier Hall que funcione ya encendió.
_ESPERAS_A_PROBAR = (0.005, 0.002, 0.001, 0.0005, 0.0002, 0.0001, 0.00005, 0.00002, 0.0)
_ESPERA_REFERENCIA = _ESPERAS_A_PROBAR[0]
_BARRIDOS_POR_ESPERA = 30
_SEGUNDOS_REPOSO = 3
_SEGUNDOS_ESTABILIDAD = 10

_AVISO_POLARIDAD = "¿Imán al revés? El A3144 solo ve el polo sur."

# Casillas ocupadas en la posición inicial (filas 1, 2, 7 y 8).
POSICION_INICIAL = frozenset(chess.SquareSet(chess.BB_RANK_1 | chess.BB_RANK_2 | chess.BB_RANK_7 | chess.BB_RANK_8))

# Cómo espera `calibrar` a que se acomoden las piezas antes de cada paso: recibe el mensaje y
# las casillas que tienen que quedar ocupadas, y vuelve cuando se aprieta Enter.
EsperarPiezas = Callable[[str, frozenset[chess.Square]], None]


class LectorMatriz(matriz.LectorMatriz):
    """`io/matriz.py::LectorMatriz` con la espera de encendido y el antirrebote de los Hall."""

    def __init__(
        self,
        espera: float = config.HALL_ESPERA_ENCENDIDO,
        lecturas_estables: int = config.HALL_LECTURAS_ESTABLES,
    ) -> None:
        super().__init__(espera, lecturas_estables)


@functools.cache
def _tabla() -> dict[Celda, chess.Square]:
    # Se valida recién al usar la matriz: un CASILLA_DE_CELDA_HALL mal pegado no tiene que
    # romper los botones del reloj, que también viven en este módulo.
    return logica_matriz.tabla_desde_config(config.CASILLA_DE_CELDA_HALL)


def casilla_de(salida: int, entrada: int) -> chess.Square:
    """Casilla de ajedrez de la celda cruda (fila Fk, columna Ck)."""
    return _tabla()[(salida, entrada)]


def ocupacion(lectura: MatrizCruda) -> frozenset[chess.Square]:
    """Convierte la matriz cruda a la `Ocupacion` que espera `logica/eventos.py`."""
    return logica_matriz.ocupacion(lectura, _tabla())


def _formatear_celdas(celdas: list[Celda]) -> str:
    return ", ".join(f"F{s} C{d}" for s, d in celdas)


def _formatear_espera(segundos: float) -> str:
    return f"{segundos * 1000:g} ms"


def probar_matriz() -> None:
    """Muestra en vivo la matriz cruda y el tablero mapeado; loguea cada cambio. Ctrl+C sale."""
    matriz.mostrar_en_vivo(LectorMatriz(), ocupacion, _LEYENDA)


# -- medir ------------------------------------------------------------------------------


def _celda_a_medir(objetivo: str) -> tuple[int, int | None]:
    """'F3' → (3, None); una casilla → su celda según CASILLA_DE_CELDA_HALL. ValueError si no.

    La fila va con F mayúscula: en minúscula, 'f3' es la casilla f3.
    """
    objetivo = objetivo.strip()
    if len(objetivo) == 2 and objetivo[0] == "F" and objetivo[1] in "01234567":
        return int(objetivo[1]), None
    casilla = chess.parse_square(objetivo.lower())
    return next(celda for celda, sq in _tabla().items() if sq == casilla)


def _voltios(valor: int) -> str:
    # 1023 es la tensión del USB, ~5 V.
    return f"{valor * 5 / 1023:.1f} V".replace(".", ",")


def _lineas_medir(columnas: tuple[bool, ...], valores: tuple[int | None, ...]) -> list[str]:
    return [
        "  pieza   " + "".join(f"{'#' if activa else '.':>7}" for activa in columnas),
        "  ADC     " + "".join(f"{'-' if v is None else v:>7}" for v in valores),
        "  tensión " + "".join(f"{'-' if v is None else _voltios(v):>7}" for v in valores),
    ]


def medir(objetivo: str) -> None:
    """Deja fija una fila para medir con el multímetro y muestra lo que lee el Nano en las columnas.

    Barriendo, cada fila está encendida 1/8 del tiempo y el multímetro marca un promedio
    que no sirve; acá la fila queda fija (`F k` del Nano) hasta Ctrl+C. Cada 0,2 s se leen
    las columnas (`C`) y su nivel con el ADC (`A`, solo las analógicas). Qué medir y qué
    tiene que dar: "Prueba con un solo driver" en hardware-docs/matriz-hall-nano.md.
    """
    try:
        fila, columna = _celda_a_medir(objetivo)
    except ValueError:
        print(f"No entiendo {objetivo!r}: usá una fila (F0..F7, con F mayúscula) o una casilla (por ejemplo e4).")
        return
    configurar_matriz()
    try:
        matriz.elegir_fila(fila)
        print(f"F{fila} encendida fija. Multímetro en voltaje continuo, punta negra en GND del Nano:")
        print(f"  1. Pin {matriz.PIN_DE_FILA[fila]} del Nano: ~5 V.")
        print(f"  2. Base del NPN de F{fila}: 0,7–0,9 V. Colector (bus de la fila): menos de 0,3 V.")
        print("  3. Punta negra en el GND de un Hall de esta fila y roja en su Vcc: 3,8 V o más.")
        if columna is None:
            print("  4. Poné piezas en esta fila: se marca un # abajo. Una columna con pieza tiene que dar")
            print("     menos de 1,3 V (ADC < 270); sin pieza, ~5 V (ADC ~1020). Más de 1,5 V: plan B.")
        else:
            print(
                f"  4. Con la pieza en {objetivo.strip().lower()} (F{fila} C{columna}), pin "
                f"{matriz.PIN_DE_COLUMNA[columna]} del Nano: menos de 1,3 V; sin la pieza, ~5 V."
            )
        print("C0–C2 no son analógicas (salen como -): esas se miden con el multímetro. Ctrl+C para salir.\n")
        print("          " + "".join(f"{f'C{c}':>7}" for c in range(8)))
        primera = True
        while True:
            lineas = _lineas_medir(matriz.leer_columnas(), matriz.leer_analogico())
            if not primera:
                print(f"\033[{len(lineas)}F", end="")  # vuelve al principio de las líneas anteriores
            print("\n".join(f"{linea}\033[K" for linea in lineas), flush=True)
            primera = False
            time.sleep(0.2)
    except KeyboardInterrupt:
        print()
    finally:
        liberar_matriz()


# -- calibrar ---------------------------------------------------------------------------


def _barrer_durante(segundos: float, espera: float) -> list[MatrizCruda]:
    fin = time.monotonic() + segundos
    lecturas = []
    while time.monotonic() < fin:
        lecturas.append(leer_matriz(espera))
    return lecturas


def _esperar_enter(mensaje: str, _esperadas: frozenset[chess.Square]) -> None:
    input(mensaje)


def _paso_reposo(esperar_piezas: EsperarPiezas) -> None:
    esperar_piezas(
        "Paso 1/3 · Reposo: sacá todas las piezas del tablero (y los imanes de cerca) y apretá Enter... ", frozenset()
    )
    lecturas = _barrer_durante(_SEGUNDOS_REPOSO, _ESPERA_REFERENCIA)
    activas = sorted({celda for lectura in lecturas for celda in celdas_activas(lectura)})
    if activas:
        print(f"  AVISO: sin piezas, estos Hall marcan pieza: {_formatear_celdas(activas)}.")
        print("  Hall dañado, mal cableado o un imán cerca. Hay que arreglarlo antes de `mapear`; se sigue igual.")
    else:
        print("  OK: ningún Hall marca pieza sin imán.")


def _paso_encendido(esperar_piezas: EsperarPiezas) -> tuple[MatrizCruda, float] | None:
    while True:
        esperar_piezas(
            "Paso 2/3 · Tiempo de encendido: armá la posición inicial (32 piezas) y apretá Enter... ", POSICION_INICIAL
        )
        lecturas = [leer_matriz(_ESPERA_REFERENCIA) for _ in range(_BARRIDOS_POR_ESPERA)]
        referencia = logica_matriz.lectura_mas_comun(lecturas)
        if celdas_activas(referencia):
            break
        print(f"  No se detectó ninguna pieza. {_AVISO_POLARIDAD} Se repite.")
    print(
        f"  Referencia ({_formatear_espera(_ESPERA_REFERENCIA)} por fila): "
        f"{len(celdas_activas(referencia))} celdas activas."
    )
    print(matriz.formatear_matriz(referencia))
    aciertos = {}
    for espera in _ESPERAS_A_PROBAR:
        iguales = sum(leer_matriz(espera) == referencia for _ in range(_BARRIDOS_POR_ESPERA))
        aciertos[espera] = iguales == _BARRIDOS_POR_ESPERA
        print(f"  {_formatear_espera(espera):>8} por fila: {iguales}/{_BARRIDOS_POR_ESPERA} lecturas iguales a la referencia")
    minima = logica_matriz.espera_minima(aciertos)
    if minima is None:
        print(
            f"  FALLA: ni con {_formatear_espera(_ESPERA_REFERENCIA)} por fila se lee siempre igual. No es un "
            "problema de tiempo: revisar las tensiones con `medir` (ver hardware-docs/matriz-hall-nano.md)."
        )
        return None
    espera = logica_matriz.recomendar_espera(minima)
    print(f"  La espera más corta que anduvo es {_formatear_espera(minima)}; se recomienda {_formatear_espera(espera)}.")
    return referencia, espera


def _paso_estabilidad(esperar_piezas: EsperarPiezas, referencia: MatrizCruda, espera: float) -> int:
    esperar_piezas(
        f"Paso 3/3 · Estabilidad: dejá las piezas y no toques el tablero durante {_SEGUNDOS_ESTABILIDAD} s. "
        "Enter para empezar... ",
        POSICION_INICIAL,
    )
    lecturas = _barrer_durante(_SEGUNDOS_ESTABILIDAD, espera)
    estable = logica_matriz.lectura_mas_comun(lecturas)
    if estable != referencia:
        print("  Las piezas no son las mismas que en el paso 2; se toma como referencia lo que se leyó ahora.")
    racha = logica_matriz.racha_maxima_distinta(lecturas, estable)
    cambios = logica_matriz.cambios_por_celda(lecturas)
    print(f"  {len(lecturas)} lecturas en {_SEGUNDOS_ESTABILIDAD} s.")
    if cambios:
        detalle = ", ".join(f"F{s} C{d} ({n} cambios)" for (s, d), n in sorted(cambios.items()))
        print(f"  Celdas que parpadearon: {detalle}.")
        print(f"  Racha más larga de lecturas falsas iguales: {racha}.")
    else:
        print("  OK: ninguna celda cambió.")
    return logica_matriz.recomendar_lecturas_estables(racha)


def calibrar(esperar_piezas: EsperarPiezas = _esperar_enter) -> None:
    """Mide la espera de encendido y el antirrebote de los Hall (HALL_* de config.py).

    Tres pasos: reposo (tablero vacío: ningún Hall tiene que marcar), tiempo de encendido
    (con piezas, prueba esperas por fila cada vez más cortas contra una lectura de
    referencia) y estabilidad (10 s sin tocar, para elegir el antirrebote). Las cuentas
    están en logica/matriz.py; detalle en software-docs/sensores.md.

    Antes de cada paso, `esperar_piezas` espera el Enter. Por defecto es un `input`;
    `prueba_tablero calibrar` pasa una que además muestra en los LEDs lo que detectan los Hall.
    """
    configurar_matriz()
    try:
        print("Calibración de los Hall, 3 pasos.\n")
        _paso_reposo(esperar_piezas)
        print()
        encendido = _paso_encendido(esperar_piezas)
        if encendido is None:
            return
        referencia, espera = encendido
        print()
        lecturas_estables = _paso_estabilidad(esperar_piezas, referencia, espera)
    except KeyboardInterrupt:
        print("\nCalibración cancelada.")
        return
    finally:
        liberar_matriz()
    print("\nCopiar en tablero/src/tablero/config.py (reemplazando los valores actuales):\n")
    print(f"HALL_ESPERA_ENCENDIDO: float = {espera}")
    print(f"HALL_LECTURAS_ESTABLES: int = {lecturas_estables}")


# -- mapear -----------------------------------------------------------------------------


def mapear() -> None:
    """Genera CASILLA_DE_CELDA_HALL de config.py: la pieza sola en cada una de las 64 casillas.

    Se usa una sola pieza: en cada paso se la mueve a la casilla que se pide y se aprieta
    Enter ('r' vuelve a la casilla anterior). De paso prueba que cada Hall detecte.
    """
    configurar_matriz()
    lector = LectorMatriz()
    asignacion: dict[chess.Square, Celda] = {}
    try:
        print("Mapeo de los Hall: sacá todas las piezas del tablero y quedate con una sola.\n")
        posicion = 0
        while posicion < len(chess.SQUARES):
            casilla = chess.SQUARES[posicion]
            nombre = chess.square_name(casilla)
            respuesta = input(
                f"[{posicion + 1}/64] Poné la pieza en {nombre} y apretá Enter ('r' repite la anterior)... "
            )
            if respuesta.strip().lower() == "r":
                if posicion == 0:
                    print("  No hay casilla anterior.")
                    continue
                posicion -= 1
                del asignacion[chess.SQUARES[posicion]]
                continue
            activas = celdas_activas(lector.esperar_estable())
            if not activas:
                print(f"  No se detectó la pieza. {_AVISO_POLARIDAD} Se repite.")
                continue
            if len(activas) > 1:
                print(f"  Se detectaron {len(activas)} celdas ({_formatear_celdas(activas)}), tiene que ser 1. Se repite.")
                continue
            celda = activas[0]
            anterior = next((sq for sq, c in asignacion.items() if c == celda), None)
            if anterior is not None:
                print(
                    f"  F{celda[0]} C{celda[1]} ya quedó como {chess.square_name(anterior)}: ¿la pieza sigue ahí? "
                    "Si te equivocaste antes, 'r'. Se repite."
                )
                continue
            asignacion[casilla] = celda
            print(f"  {nombre} → F{celda[0]} C{celda[1]}")
            posicion += 1
    except KeyboardInterrupt:
        print("\nMapeo cancelado.")
        return
    finally:
        liberar_matriz()

    print("\nCopiar en tablero/src/tablero/config.py, reemplazando las 10 líneas del CASILLA_DE_CELDA_HALL actual:\n")
    print(logica_matriz.formatear_tabla_config(asignacion))
    if logica_matriz.es_grilla(asignacion):
        print("\nEl cableado es una grilla: cada fila F es una fila del tablero y cada columna C una columna.")
    else:
        print(
            "\nOjo: el cableado no es una grilla (hay filas F con casillas de varias filas del tablero, o columnas C de "
            "varias columnas). La tabla funciona igual; si no era lo esperado, revisar el cableado."
        )


if __name__ == "__main__":
    logging.basicConfig(level=logging.INFO, format="%(asctime)s %(levelname)s %(message)s")
    parser = argparse.ArgumentParser(description="Pruebas manuales de los sensores del tablero (matriz con Hall).")
    parser.add_argument(
        "prueba",
        nargs="?",
        default="botones",
        choices=["botones", "medir", "matriz", "calibrar", "mapear"],
        help=(
            "botones: reloj (por defecto); medir: dejar una fila fija para el multímetro; "
            "matriz: ver la grilla en vivo; calibrar: espera de encendido y antirrebote; "
            "mapear: generar la tabla celda → casilla"
        ),
    )
    parser.add_argument(
        "objetivo", nargs="?", help="solo para medir: una fila (F0..F7, F mayúscula) o una casilla (e4)"
    )
    parser.add_argument(
        "--sin-leds",
        action="store_true",
        help="solo para calibrar: sin mostrar en los LEDs lo que detectan los Hall (y sin sudo)",
    )
    argumentos = parser.parse_args()
    if argumentos.prueba == "medir" and argumentos.objetivo is None:
        parser.error("medir necesita una fila o una casilla, por ejemplo: medir F0")
    if argumentos.prueba != "medir" and argumentos.objetivo is not None:
        parser.error(f"{argumentos.prueba} no lleva argumentos")
    if argumentos.prueba != "calibrar" and argumentos.sin_leds:
        parser.error("--sin-leds es solo para calibrar")
    if argumentos.prueba == "calibrar" and not argumentos.sin_leds:
        # Con los LEDs es `prueba_tablero calibrar`, que se relanza solo con sudo (rpi-ws281x
        # necesita root). Este proceso se reemplaza: no queda abierto el puerto del Nano.
        os.execv(sys.executable, [sys.executable, "-m", "tablero.io.prueba_tablero", "calibrar"])
    try:
        if argumentos.prueba == "medir":
            assert argumentos.objetivo is not None  # validado arriba con parser.error
            medir(argumentos.objetivo)
        else:
            {
                "botones": probar_botones_reloj,
                "matriz": probar_matriz,
                "calibrar": calibrar,
                "mapear": mapear,
            }[argumentos.prueba]()
    except matriz.ErrorNano as error:
        print(f"Error con el Nano: {error}", file=sys.stderr)
        sys.exit(1)
