tino7902/tablero-ajedrez-inteligente/tablero/src/tablero/io/leds.py

"""LEDs WS2812B del tablero: uno por casilla (más el LED de sacrificio, si hay; ver config.py).

Usa `rpi-ws281x` sobre GPIO 12 (pin físico 32, PWM0). Necesita root para acceder a
`/dev/mem` y el audio analógico desactivado (`dtparam=audio=off` en config.txt),
porque comparte el periférico PWM — ver software-docs/leds.md.

Pruebas manuales en la Raspberry (desde tablero/). Si no se corre como root, el
módulo se relanza solo con `sudo` usando el mismo Python del .venv:

    uv run python -m tablero.io.leds todos
    uv run python -m tablero.io.leds recorrer
    uv run python -m tablero.io.leds esquinas
    uv run python -m tablero.io.leds calibrar
    uv run python -m tablero.io.leds verificar
"""

import argparse
import logging
import os
import sys
import time

import chess
from rpi_ws281x import Color, PixelStrip  # pyright: ignore[reportMissingImports] (solo en la Pi)

from tablero import config

logger = logging.getLogger(__name__)

APAGADO: int = Color(0, 0, 0)
BLANCO: int = Color(255, 255, 255)
ROJO: int = Color(255, 0, 0)
VERDE: int = Color(0, 255, 0)
AZUL: int = Color(0, 0, 255)
AMARILLO: int = Color(255, 255, 0)
BLANCO_TENUE: int = Color(70, 70, 70)  # destinos posibles en io/juego.py: que no compitan con el resto
VIOLETA: int = Color(170, 0, 255)  # vs Magnus: casillas que tienen que quedar vacías
CIAN: int = Color(0, 255, 255)  # vs Magnus: adonde va la pieza de Magnus


def indice_de(casilla: chess.Square) -> int:
    """Índice en la tira del LED de `casilla`, según LED_DE_CASILLA (ver config.py)."""
    return config.LED_DE_CASILLA[casilla]


class TiraLeds:
    """Envoltorio de `PixelStrip` que habla en casillas y mantiene apagado el LED de sacrificio (si hay)."""

    def __init__(self, brillo: int = config.LED_BRILLO) -> None:
        if brillo > config.LED_BRILLO_MAX:
            logger.warning("Brillo %d por encima del tope: se usa %d (LED_BRILLO_MAX)", brillo, config.LED_BRILLO_MAX)
            brillo = config.LED_BRILLO_MAX
        self._tira = PixelStrip(
            config.LED_CANTIDAD,
            config.LED_GPIO_BCM,
            brightness=brillo,
            channel=config.LED_CANAL_PWM,
        )
        self._tira.begin()

    def encender(self, casilla: chess.Square, color: int) -> None:
        self._tira.setPixelColor(indice_de(casilla), color)

    def encender_indice(self, indice: int, color: int) -> None:
        self._tira.setPixelColor(indice, color)

    def limpiar(self) -> None:
        for indice in range(config.LED_CANTIDAD):
            self._tira.setPixelColor(indice, APAGADO)

    def mostrar(self) -> None:
        """Envía los colores a la tira (nada cambia hasta llamar a esto)."""
        if config.LED_INDICE_SACRIFICIO is not None:
            self._tira.setPixelColor(config.LED_INDICE_SACRIFICIO, APAGADO)
        self._tira.show()

    def apagar(self) -> None:
        self.limpiar()
        self.mostrar()


def _probar_todos(tira: TiraLeds) -> None:
    """Enciende las 64 casillas en rojo, verde, azul y blanco (brillo bajo)."""
    for nombre, color in (("rojo", ROJO), ("verde", VERDE), ("azul", AZUL), ("blanco", BLANCO)):
        logger.info("Todas las casillas en %s", nombre)
        for casilla in chess.SQUARES:
            tira.encender(casilla, color)
        tira.mostrar()
        time.sleep(2)


def _probar_recorrer(tira: TiraLeds) -> None:
    """Enciende de a un LED por índice de la tira, para anotar en qué casilla cae cada uno."""
    for indice in range(config.LED_CANTIDAD):
        if indice == config.LED_INDICE_SACRIFICIO:
            continue
        tira.limpiar()
        tira.encender_indice(indice, BLANCO)
        tira.mostrar()
        input(f"LED {indice} encendido (Enter para el siguiente)... ")


def _probar_esquinas(tira: TiraLeds) -> None:
    """Enciende a1, h1, a8 y h8 con colores distintos a través del mapeo casilla → LED."""
    esquinas = ((chess.A1, ROJO, "rojo"), (chess.H1, VERDE, "verde"), (chess.A8, AZUL, "azul"), (chess.H8, AMARILLO, "amarillo"))
    tira.limpiar()
    for casilla, color, nombre in esquinas:
        tira.encender(casilla, color)
        logger.info("%s → LED %d (%s)", chess.square_name(casilla), indice_de(casilla), nombre)
    tira.mostrar()
    input("Verificar que cada color esté en su esquina (Enter para terminar)... ")


def _probar_verificar(tira: TiraLeds) -> None:
    """Recorre a1, b1, ..., h8 a través de LED_DE_CASILLA: la luz tiene que avanzar en orden."""
    for casilla in chess.SQUARES:
        tira.limpiar()
        tira.encender(casilla, VERDE)
        tira.mostrar()
        input(f"{chess.square_name(casilla)} (LED {indice_de(casilla)}) — Enter para la siguiente... ")


class _RepetirAnterior(Exception):
    pass


def _pedir_casilla(indice: int, ya_asignadas: dict[chess.Square, int]) -> chess.Square | None:
    """Pregunta en qué casilla cayó el LED `indice`. None = no cae en ninguna casilla."""
    while True:
        respuesta = input(f"LED {indice}: ¿en qué casilla está? (ej. e4, '-' si en ninguna, 'r' repetir anterior) ").strip().lower()
        if respuesta == "-":
            return None
        if respuesta == "r":
            raise _RepetirAnterior
        try:
            casilla = chess.parse_square(respuesta)
        except ValueError:
            print("  No es una casilla válida (a1..h8).")
            continue
        if casilla in ya_asignadas:
            print(f"  {respuesta} ya está asignada al LED {ya_asignadas[casilla]}. Usá 'r' si te equivocaste antes.")
            continue
        return casilla


def _probar_calibrar(tira: TiraLeds) -> None:
    """Genera LED_DE_CASILLA de config.py: prende cada LED y pide en qué casilla cayó."""
    print("Calibración de LEDs: se prende un LED por vez; escribí la casilla donde lo ves.\n")
    indices = [i for i in range(config.LED_CANTIDAD) if i != config.LED_INDICE_SACRIFICIO]
    asignadas: dict[chess.Square, int] = {}
    historial: list[chess.Square | None] = []
    posicion = 0
    while posicion < len(indices):
        indice = indices[posicion]
        tira.limpiar()
        tira.encender_indice(indice, BLANCO)
        tira.mostrar()
        try:
            casilla = _pedir_casilla(indice, asignadas)
        except _RepetirAnterior:
            if posicion == 0:
                print("  No hay LED anterior.")
                continue
            posicion -= 1
            anterior = historial.pop()
            if anterior is not None:
                del asignadas[anterior]
            continue
        historial.append(casilla)
        if casilla is not None:
            asignadas[casilla] = indice
        posicion += 1

    faltantes = [chess.square_name(c) for c in chess.SQUARES if c not in asignadas]
    if faltantes:
        print(f"\nFaltan casillas sin LED: {', '.join(faltantes)}. Revisar la tira y repetir.")
        return
    print("\nCopiar en tablero/src/tablero/config.py (reemplazando el LED_DE_CASILLA actual):\n")
    print(formatear_led_de_casilla(tuple(asignadas[c] for c in chess.SQUARES)))


def formatear_led_de_casilla(tabla: tuple[int, ...]) -> str:
    """Bloque `LED_DE_CASILLA` listo para pegar en config.py, una fila de ajedrez por línea."""
    lineas = ["LED_DE_CASILLA: tuple[int, ...] = ("]
    for fila in range(8):
        valores = ", ".join(f"{i:2d}" for i in tabla[fila * 8 : fila * 8 + 8])
        lineas.append(f"    {valores},  # fila {fila + 1}: a..h")
    lineas.append(")")
    return "\n".join(lineas)


if __name__ == "__main__":
    if os.geteuid() != 0:
        # rpi-ws281x necesita root (/dev/mem). sys.executable es el Python del .venv,
        # así root usa las mismas dependencias sin pasar por `sudo uv run`.
        os.execvp("sudo", ["sudo", sys.executable, "-m", "tablero.io.leds", *sys.argv[1:]])
    logging.basicConfig(level=logging.INFO, format="%(asctime)s %(levelname)s %(message)s")
    parser = argparse.ArgumentParser(description="Pruebas manuales de los LEDs del tablero.")
    parser.add_argument(
        "prueba",
        choices=["todos", "recorrer", "esquinas", "calibrar", "verificar"],
        help=(
            "todos: colores en todo el tablero; recorrer: LED por LED; esquinas: a1/h1/a8/h8; "
            "calibrar: generar LED_DE_CASILLA; verificar: recorrer a1..h8 con el mapeo"
        ),
    )
    parser.add_argument("--brillo", type=int, default=config.LED_BRILLO, help=f"0-{config.LED_BRILLO_MAX}")
    argumentos = parser.parse_args()
    tira = TiraLeds(argumentos.brillo)
    pruebas = {
        "todos": _probar_todos,
        "recorrer": _probar_recorrer,
        "esquinas": _probar_esquinas,
        "calibrar": _probar_calibrar,
        "verificar": _probar_verificar,
    }
    try:
        pruebas[argumentos.prueba](tira)
    except KeyboardInterrupt:
        pass
    finally:
        tira.apagar()
        logger.info("LEDs apagados, saliendo.")
