tino7902/tablero-ajedrez-inteligente/tablero/src/tablero/config.py

"""Configuración general del proyecto (pines GPIO, motor, etc.)."""

import os
import shutil
from pathlib import Path
from typing import NamedTuple

# Donde lo instala `apt install stockfish` en Raspberry Pi OS. `io/juego.py` se relanza con
# sudo por los LEDs, y el PATH de sudo (secure_path) normalmente no incluye /usr/games.
_STOCKFISH_APT = "/usr/games/stockfish"


def buscar_stockfish() -> str:
    """Ruta al binario de stockfish: primero el PATH, después el de apt.

    Si no está en ningún lado devuelve el nombre solo, para que el error al abrir el
    motor sea explícito.
    """
    if ruta := shutil.which("stockfish"):
        return ruta
    if os.access(_STOCKFISH_APT, os.X_OK):
        return _STOCKFISH_APT
    return "stockfish"


STOCKFISH_PATH: str = buscar_stockfish()
STOCKFISH_MOVETIME: float = 1.0  # segundos por jugada sin nivel, ver motor/stockfish.py


class NivelMagnus(NamedTuple):
    """Un nivel de Magnus (Stockfish) en el modo vs-máquina, ver motor/stockfish.py."""

    nombre: str  # para mostrar, con tildes: "fácil"
    skill_level: int  # opción UCI `Skill Level` de Stockfish, 0-20
    segundos_por_jugada: float


# Niveles del modo vs Magnus. Las claves van en ASCII porque son flags de la terminal
# (`juego.py --magnus facil`). Son valores iniciales para afinar jugando (por ejemplo con
# `uv run python -m tablero.simulacion --magnus facil`): `Skill Level 0` anda por los
# 1300 Elo según la calibración de Stockfish. Ver software-docs/vs-magnus.md.
NIVELES_MAGNUS: dict[str, NivelMagnus] = {
    "facil": NivelMagnus("fácil", 0, 0.1),
    "medio": NivelMagnus("medio", 6, 0.5),
    "dificil": NivelMagnus("difícil", 20, 1.0),
}

# Pantalla táctil RPI LCD V3 (480x320, ILI9486 + touch XPT2046), ver io/pantalla.py.
# Requiere el overlay de kernel `piscreen` activado en config.txt de la Raspberry; la
# rotación física se configura ahí (parámetro `rotate=`), no acá, porque el driver ya
# entrega el framebuffer con la orientación final.
PANTALLA_ANCHO: int = 480
PANTALLA_ALTO: int = 320
PANTALLA_TAMANO_FUENTE: int = 48

# Coeficientes de calibración táctil generados por io/calibracion_touch.py (ver
# "Precisión táctil" en software-docs/pantalla.md). No se trackea en git: depende
# del panel físico específico, igual que el rotate= del overlay piscreen.
CALIBRACION_TOUCH_PATH: Path = (
    Path(__file__).resolve().parent.parent.parent / "calibracion_touch.json"
)

# Reloj de ajedrez: botones físicos (2x interruptores fin de carrera / limit
# switches), ver io/sensores.py. Cada uno conecta el pin a GND al presionarse
# (activo en bajo); numeración BOARD (física), igual que en
# hardware-docs/componentes.md, sección "Asignación de Pines GPIO"; equivalente
# BCM entre paréntesis.
PIN_BOTON_RELOJ_JUGADOR_1: int = 33  # GPIO 13 (BCM)
PIN_BOTON_RELOJ_JUGADOR_2: int = 35  # GPIO 19 (BCM)

# -- Matriz de detección de casillas: Arduino Nano (v3) ------------------------------
# Un Arduino Nano barre la matriz (un NPN por fila) y la Pi le pide cada lectura por USB
# serie, ver io/matriz.py, firmware/matriz-nano/ y hardware-docs/matriz-hall-nano.md.
# Puerto serie del Nano. None = autodetectar: se usa el único /dev/ttyUSB* o /dev/ttyACM*
# que haya; si hay varios, poner acá el del Nano (mejor el de /dev/serial/by-id/, que no
# cambia entre reinicios).
NANO_PUERTO: str | None = None

# -- Matriz: versión Hall (la actual, io/sensores.py) --------------------------------
# 64 sensores Hall A3144 / KY-003, con el GND de cada uno en el bus de su fila: el NPN de
# la fila elegida lo conecta a GND y enciende solo esos 8 Hall (ver
# hardware-docs/matriz-hall-nano.md).
#
# Segundos que espera el Nano en cada fila, después de encenderla, antes de leer las
# columnas: lo que tardan los Hall en arrancar. Se le manda en microsegundos con `L <µs>`
# (máximo 50 ms). Medido con `uv run python -m tablero.io.sensores calibrar` el 2026-10-22,
# con las 32 piezas (ver software-docs/sensores.md): 0,1 ms, el mínimo que recomienda.
HALL_ESPERA_ENCENDIDO: float = 0.0001
# Lecturas iguales seguidas que tiene que dar la matriz antes de reportar un cambio
# (antirrebote del paso de la mano y de los Hall que dudan en el borde de la casilla).
# También lo recomienda `calibrar` (2026-10-22: 3, el mínimo).
HALL_LECTURAS_ESTABLES: int = 3
# Mapeo celda → casilla, uno por sensor: CASILLA_DE_CELDA_HALL[fila Fk][columna Ck] =
# nombre de la casilla, con Fk y Ck los números de cable de hardware-docs/matriz-hall-nano.md
# (los mismos que eran Yk del 74HC138 y Dk del 74HC165 en la v2). Sirve aunque el cableado
# no sea una grilla. Generado con `uv run python -m tablero.io.sensores mapear` el
# 2026-10-22, con el tablero girado 90° (ver software-docs/sensores.md), y espejado a mano
# (a↔h) porque se había mapeado con a1 en la esquina de h1: es una grilla, F0 = columna a …
# F7 = columna h y C0..C7 = filas 1..8.
CASILLA_DE_CELDA_HALL: tuple[tuple[str, ...], ...] = (
    ("h1", "g1", "f1", "e1", "d1", "c1", "b1", "a1"),  # F0: C0..C7
    ("h2", "g2", "f2", "e2", "d2", "c2", "b2", "a2"),  # F1: C0..C7
    ("h3", "g3", "f3", "e3", "d3", "c3", "b3", "a3"),  # F2: C0..C7
    ("h4", "g4", "f4", "e4", "d4", "c4", "b4", "a4"),  # F3: C0..C7
    ("h5", "g5", "f5", "e5", "d5", "c5", "b5", "a5"),  # F4: C0..C7
    ("h6", "g6", "f6", "e6", "d6", "c6", "b6", "a6"),  # F5: C0..C7
    ("h7", "g7", "f7", "e7", "d7", "c7", "b7", "a7"),  # F6: C0..C7
    ("h8", "g8", "f8", "e8", "d8", "c8", "b8", "a8"),  # F7: C0..C7
)
# -- Matriz: versión reed (la anterior, io/sensores_reed.py) -------------------------
# Se conserva por si se vuelve a los reed switches (ver software-docs/sensores-reed.md).
#
# Lecturas iguales seguidas que tiene que dar la matriz antes de reportar un cambio
# (antirrebote de los reed switches y del paso de la mano sobre el tablero).
REED_LECTURAS_ESTABLES: int = 3

# Mapeo matriz cruda → casilla de ajedrez. La matriz se lee como
# [salida Y0..Y7 del 74HC138][entrada D0..D7 del 74HC165]; cada salida es una fila
# física y cada entrada una columna física, así que alcanza con dos permutaciones:
#   FILA_DE_SALIDA_138[y]  = fila de ajedrez (0 = fila 1, 7 = fila 8)
#   COLUMNA_DE_ENTRADA_165[d] = columna de ajedrez (0 = columna a, 7 = columna h)
# Los valores de abajo son un placeholder (identidad): en el esquemático las columnas
# no entran en orden al 74HC165. Se generan con
# `uv run python -m tablero.io.sensores_reed calibrar` (ver software-docs/sensores-reed.md).
FILA_DE_SALIDA_138: tuple[int, ...] = (0, 1, 2, 3, 4, 5, 6, 7)
COLUMNA_DE_ENTRADA_165: tuple[int, ...] = (0, 1, 2, 3, 4, 5, 6, 7)

# LEDs WS2812B, ver io/leds.py. rpi-ws281x usa numeración BCM (no BOARD): GPIO 12
# es el pin físico 32, canal PWM0. Había un LED 0 de sacrificio (adaptaba el nivel de la
# señal de datos, ver hardware-docs/componentes.md) que se quemó el 2026-10-22: desde ahí
# la señal entra directo al LED de h8 y la tira tiene solo los 64 de las casillas. Si se
# vuelve a poner uno, LED_CANTIDAD = 65, LED_INDICE_SACRIFICIO = 0 y sumarle 1 a la tabla.
LED_GPIO_BCM: int = 12
LED_CANAL_PWM: int = 0
LED_CANTIDAD: int = 64
LED_INDICE_SACRIFICIO: int | None = None  # None = sin LED de sacrificio
LED_BRILLO: int = (
    32  # 0-LED_BRILLO_MAX; bajo por defecto: 64 LEDs en blanco al máximo son ~3,8 A
)
# Tope del brillo (75 % de 255): TiraLeds no pasa de acá aunque se pida más con --brillo.
LED_BRILLO_MAX: int = 191
# Mapeo casilla → índice en la tira: LED_DE_CASILLA[chess.Square] (0 = a1, 1 = b1, ...,
# 63 = h8). Generado con `uv run python -m tablero.io.prueba_tablero leds` el
# 2026-10-22 (ver software-docs/prueba-tablero.md) y espejado a mano (a↔h), igual que
# CASILLA_DE_CELDA_HALL: la tira va en serpentina por columnas desde h8 (columna h de 8 a 1,
# columna g de 1 a 8, ...). Índices corridos en -1 el 2026-10-22 al sacar el LED de sacrificio.
# fmt: off
LED_DE_CASILLA: tuple[int, ...] = (
    63, 62, 61, 60, 59, 58, 57, 56,  # fila 1: a..h
    48, 49, 50, 51, 52, 53, 54, 55,  # fila 2: a..h
    47, 46, 45, 44, 43, 42, 41, 40,  # fila 3: a..h
    32, 33, 34, 35, 36, 37, 38, 39,  # fila 4: a..h
    31, 30, 29, 28, 27, 26, 25, 24,  # fila 5: a..h
    16, 17, 18, 19, 20, 21, 22, 23,  # fila 6: a..h
    15, 14, 13, 12, 11, 10,  9,  8,  # fila 7: a..h
     0,  1,  2,  3,  4,  5,  6,  7,  # fila 8: a..h
)
# fmt: on
# Registro de partidas (ver logica/registro.py y software-docs/registro.md). No se
# trackea en git: son datos de ejecución, igual que la calibración táctil.
DIRECTORIO_REGISTROS: Path = Path(__file__).resolve().parent.parent.parent / "registros"
MAX_PARTIDAS_REGISTRADAS: int = 15  # PGN (movimientos legales + resultado)
MAX_DETALLES_REGISTRADOS: int = 5  # log detallado de eventos
