tino7902/tablero-ajedrez-inteligente/(commit log)

2026-08-06 docs de la parte de validacion de jugadas y motor stockfish
2026-08-08 se actualizo una dependencia que debe ser compilada desde source
2026-08-10 actualizacion de documentacion referente al hardware
2026-08-10 actualizar CLAUDE.md con el estado real del proyecto
    Refleja los módulos ya implementados (estado_tablero, stockfish, pantalla),
    la nueva ubicación de la documentación (hardware-docs/, software-docs/) y
    que pytest ya corre.
2026-08-10 documentar precision tactil observada y consideraciones de diseño de UI
    Al probar probar_boton() en hardware real, el touch registra el contacto
    pero la coordenada reportada no siempre coincide con el punto tocado.
    Se documenta el hallazgo en pantalla.md y se agrega
    consideracion-sobre-diseño.md con la guia para futuras UIs tactiles
    (elementos grandes, separacion generosa, evitar UI densa).
2026-08-10 implementar deteccion de movimientos a partir de diffs de ocupacion
    logica/eventos.py traduce snapshots sucesivos de ocupacion de casillas en
    chess.Move: detecta pieza levantada, valida el movimiento candidato y, si es
    ilegal, espera a que se retome la misma pieza (origen logico fijo) y se
    coloque en una casilla valida. Capturas, enroque y al paso se detectan y se
    rechazan explicitamente (fuera de alcance v1) en vez de aplicarse mal.
2026-08-11 se agrego un boceto de la interfaz de usuario
2026-08-11 mejora de los bocetos de interfaz
2026-08-12 se agrego una funcion de calibracion touch
2026-08-12 prueba de interfaz
2026-08-13 soluciuon interfaz en pc + ahora te elige bien el color
2026-08-13 intento de bug fix #1
    [menus.py]
2026-08-13 intento de bug fix #2
    [_sdl.py]
2026-08-17 bug de volver resuelto
    [menus.py]
2026-08-26 fix: restringir rpi-lgpio/rpi-ws281x/pygame a Linux ARM en pyproject.toml
    Estas dependencias son especificas de hardware de la Raspberry Pi (GPIO real,
    DRM-KMS, PWM de Broadcom) y uv sync fallaba en Windows al intentar compilar la
    extension en C de rpi-ws281x sin Visual C++ Build Tools. Se les agrega un
    environment marker (PEP 508) para que solo se instalen en Linux ARM, en linea
    con el boundary io/ (Pi-only) vs logica//motor/ (multiplataforma) que ya
    documenta CLAUDE.md.
2026-08-26 fix: no restringir pygame a Linux ARM, solo su build desde fuente
    El commit anterior le puso el mismo marker de Linux ARM a pygame que a
    rpi-lgpio/rpi-ws281x, pero eso rompe el modo ventana de menus.py
    (TABLERO_PANTALLA_VENTANA=1), que existe justamente para probar la UI en
    cualquier notebook sin la Raspberry: pygame sí hace falta fuera de la Pi.
    Lo que sí es Pi-only es compilarlo desde fuente para enlazar contra el SDL2
    del sistema con soporte KMSDRM. Ese "no-binary-package = [pygame]" vivía como
    config global en [tool.uv] y forzaba el build desde fuente en toda maquina,
    lo que fallaba en Windows por falta del toolchain MSYS2/pacman de pygame
    (mismo sintoma que el problema original de r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
2026-08-27 bug fixes para windows
    [_sdl.py]
2026-08-30 funcion de simulacion de partida añadida. abstraccion del reloj fuera de /io. test y logs para simulacion. registro de ultimas partidas
2026-09-24 apunto de probar
2026-10-06 prueba leds
2026-10-06 sudo para los leds
2026-10-14 checklist para prueba iman
2026-10-14 testeo de imanes ready
2026-10-17 sensores hall como default, version reed conservada
    - io/matriz.py: driver comun del 74HC138/74HC165 para las dos versiones
    - io/sensores.py: botones (sin cambios) + matriz con sensores Hall A3144/KY-003:
    medir, matriz, calibrar (espera de encendido y antirrebote), mapear (64 casillas)
    - io/sensores_reed.py: version anterior con reed switches, mismos comandos
    - io/prueba_tablero.py: sensores + LEDs (asociar LEDs, recorrido, espejo, inicial)
    - logica/matriz.py + tests/test_matriz.py: procesamiento sin hardware
    - docs: checklist Hall, celdas Hall con riesgos electricos, sensores-reed
    Claude-Session: https://claude.ai/code/session_01FLJ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
2026-10-17 guia de redes wifi en la raspberry
    Claude-Session: https://claude.ai/code/session_01BrGSkkiHeASWnQXpBp71R6
2026-10-17 docs: matriz Hall con Arduino Nano (v3) e historial de iteraciones
    El 74HC138 no aguanta la corriente de los Hall (la Y activa daba 1,6 V).
    Se decide pasar a un Arduino Nano con un NPN por fila y los Hall a 5 V,
    conectado a la Pi por USB. Se documenta la guía de armado, el historial
    v1/v2/v3 con las alternativas descartadas, y se marcan como versiones
    anteriores los docs del 138/165. El software todavía no cambió.
    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
2026-10-17 docs: notas de la v3 (Nano) en comandos, eventos, testing y config
    Los comandos de la matriz y los pines del 138/165 en config.py quedan
    marcados como v2 descartada. Se suma la fuente HTML de la guía de armado
    (versión web publicada).
    Claude-Session: https://claude.ai/code/session_01DUzujX1ofm8jNaGh4z9G6j
2026-10-17 docs: celdas Hall soldadas con el diodo en el GND, drivers NPN más fuertes
    Las 64 celdas quedaron con el diodo en el GND de cada Hall y la salida
    directo a la columna. Con la fila llena pueden pasar ~200 mA, así que los
    NPN pasan a BC337/2N2222/S8050 con base de 470 Ω, se descartan las
    pull-ups externas y se documenta un plan B con analogRead en las columnas.
    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
2026-10-17 firmware: Arduino Nano de la matriz Hall (v3) con protocolo por comandos
    El Nano barre la matriz solo cuando se lo piden por USB serie (115200):
    ?, L [µs], F k, C, X, A y V, una línea por comando y una por respuesta.
    El antirrebote, la calibración y el mapeo siguen en Python; cada comando
    equivale a una función de io/matriz.py, así el lado Pi cambia poco, y los
    mismos comandos sirven para probar el hardware desde el monitor serie.
    El plan B (columnas analógicas) se activa compilando con PLAN_B=1.
    Compila sin warnings en las dos variantes; todavía no corrió en un Nano
    real. La guía de armado (md, html y artifact) pasa a usar el firmware en
    la prueba con un driver. El lector serie de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
2026-10-17 firmware: bootloader nuevo por defecto y LISTO en su propia línea
    El Nano del proyecto tiene el bootloader nuevo (Optiboot, 115200): con
    cpu=atmega328old la subida fallaba con "not in sync". La doc pasa a usar
    cpu=atmega328 y deja el viejo como alternativa.
    Al abrir el puerto el reset mete basura por el USB, que caía en la misma
    línea que el LISTO. El firmware manda una línea vacía antes, y el
    protocolo dice que hay que descartar todo hasta ese LISTO.
    Claude-Session: https://claude.ai/code/session_01AZhC4jM7CCuVFg6nZpSeAg
2026-10-18 logica: protocolo del Nano y etiquetas F/C en la matriz
    Armar el comando de barrido (L <µs>) y decodificar las respuestas del
    firmware (M, C, A y el LISTO) como funciones puras, testeadas en
    test_matriz.py. Los mensajes y el bloque que imprime mapear usan los
    nombres de cable de la v3 (fila Fk, columna Ck) en vez de Yk/Dk.
    Claude-Session: https://claude.ai/code/session_01EFULyqmnqCsaKWmmLK1paY
2026-10-18 io: la matriz se lee del Arduino Nano por el puerto serie
    io/matriz.py deja el 74HC138 + 74HC165 por GPIO y le habla al firmware
    del Nano con pyserial, con la misma API (configurar_matriz, leer_matriz,
    LectorMatriz), así que calibrar, mapear, prueba_tablero y la versión reed
    no cambian. Espera el LISTO al abrir el puerto, reintenta respuestas mal
    formadas y convierte cualquier falla del puerto en ErrorNano con qué
    revisar. medir toma una fila F0..F7 y muestra C y A en vivo; se van
    selector y lector. config.py: NANO_PUERTO (autodetectado por defecto) en
    lugar de los PIN_MATRIZ_*.
    Claude-Session: https://claude.ai/code/session_01EFULy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
2026-10-18 docs: lado Pi de la matriz v3 y matriz probada con el Nano
    La matriz detecta las 64 casillas con el Nano (plan A, desde la notebook);
    falta probarla enchufada a la Pi. sensores.md describe el driver serie,
    el puerto, los errores y el nuevo medir; firmware-nano.md, comandos.md,
    config.md, testing.md, pyproject.md, sensores-reed.md, la guía de la v3 y
    CLAUDE.md se ponen al día.
    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
2026-10-18 docs: prueba_tablero con el Nano en vez de los pines de la matriz
    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
2026-10-18 hall mapeados
2026-10-18 leds mapeados
2026-10-18 docs: matriz, LEDs y prueba_tablero probados en la Pi
    Mapeo de los Hall y de los LEDs generados y pegados; prueba_tablero
    recorrido y espejo funcionan. Quedan calibrar y prueba_tablero inicial,
    que necesitan las 32 piezas. Alimentación provisoria: un cargador para
    la Pi y otro para LEDs + Nano.
    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
2026-10-18 logica: jugadas detectadas por ocupación y PartidaFisica
    eventos.py compara cada lectura con la ocupación que dejaría cada jugada
    legal, así que soporta capturas, enroque, al paso y promoción (a dama), y
    ya no aplica la jugada por su cuenta. Las capturas de una misma pieza se
    desempatan por las casillas que se vaciaron y se volvieron a ocupar.
    marcas() dice qué mostrar en cada casilla.
    Partida.intentar_jugada acepta un chess.Move ya resuelto. PartidaFisica
    une las dos cosas: la jugada cuenta al apretar el botón del reloj.
    Claude-Session: https://claude.ai/code/session_01S7R5oThBZTwEprsFr8e6iJ
2026-10-18 io: juego.py, la partida en el tablero físico por terminal
    Une la matriz del Nano, los botones del reloj y los LEDs con PartidaFisica.
    Espera la posición de arranque, acepta --fen para probar con pocos imanes,
    se relanza con sudo (salvo --sin-leds) y devuelve los registros al usuario.
    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
2026-10-18 docs: detección de jugadas, PartidaFisica y juego.py
    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
2026-10-18 docs: formato FEN de --fen en juego.md
    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
2026-10-18 leds: tope de brillo al 75 % (LED_BRILLO_MAX)
    TiraLeds no pasa de 191 aunque --brillo pida más, y avisa por el log.
    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
2026-10-18 docs: diseño del modo Jugador vs Magnus
    Spec del modo vs-máquina en el tablero físico, todavía sin implementar:
    reloj sin límite, jugada de Magnus confirmada con el botón, LEDs y textos
    por fase, niveles de Stockfish en config.py, PartidaVsMagnus como lógica
    pura y el motor en un hilo desde juego.py --magnus. Incluye tests y orden.
    Claude-Session: https://claude.ai/code/session_01BiEsq8aCbMyw4kFaLjsjtD
2026-10-21 magnus: modo vs Magnus en el tablero físico y en la simulación
    - logica/partida_magnus.py: PartidaVsMagnus sobre PartidaFisica, sin límite de tiempo
    - io/juego.py --magnus {facil,medio,dificil}, Stockfish en un hilo aparte
    - config: NIVELES_MAGNUS y búsqueda de stockfish en /usr/games (PATH de sudo)
    - reloj sin límite, rendirse, niveles en motor/stockfish.py
    - simulacion --magnus, tests y docs; software-docs/pendiente-pi.md
    Claude-Session: https://claude.ai/code/session_01P5bqc5SQDXuLwSPsCXkw5u
2026-10-22 mapeo leds
2026-10-22 sensores: calibrar con los LEDs mostrando lo que detectan los Hall
    `prueba_tablero calibrar` corre la misma calibración que `sensores calibrar`,
    pero mientras espera el Enter de cada paso pinta en vivo cada casilla contra lo
    que tiene que haber (verde bien, rojo falta, amarillo sobra): los Hall solo ven
    la pieza justo encima, así que sirve para acomodarlas antes de medir.
    `sensores.calibrar` recibe cómo esperar las piezas (por defecto, `input`), y
    `POSICION_INICIAL` pasa a `sensores` para usarla desde los dos lados.
    Docs: los dos mapeos se rehicieron con el tablero girado 90°.
    Claude-Session: https://claude.ai/code/session_0129cX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
2026-10-22 sensores: calibrar se relanza como prueba_tablero calibrar (con LEDs)
    `sensores calibrar` no prendía los LEDs: hacía falta llamar a
    `prueba_tablero calibrar`. Ahora se reemplaza por ese, que se relanza con
    sudo; `--sin-leds` deja la calibración de antes, sin LEDs ni sudo.
    Claude-Session: https://claude.ai/code/session_0129cXVYf9Z2u6pY7nnKkocH
2026-10-22 config: Hall calibrados con las 32 piezas (0,1 ms, 3 lecturas)
    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
2026-10-22 eventos: la pieza que puede capturar, levantada, no es la captura
    Con la pieza que captura en la mano la ocupación es la misma que con la
    captura hecha (la casilla capturada sigue ocupada). Con una sola captura
    posible se tomaba como jugada: los LEDs mostraban solo esa, en verde, en vez
    de todos los destinos. Ahora una captura cuenta solo si se vio vaciarse y
    volver a ocuparse la casilla capturada (la regla que ya desempataba varias
    capturas); si no, es AMBIGUA y se marca como la pieza levantada.
    Lo mismo en vs Magnus al revés: con la pieza de Magnus en la mano su captura
    ya parecía terminada. PartidaVsMagnus recuerda la casilla capturada hasta
    verla vacía.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
2026-10-22 config: mapeos de Hall y LEDs espejados (a↔h)
    Se habían mapeado con a1 en la esquina de h1. Como el mapeo de LEDs sale de
    los Hall, quedaban coherentes entre sí y pasaban recorrido e inicial; se
    notó al enrocar (el rey se leía en d1). Se espejan las dos tablas a mano en
    vez de rehacer los 128 pasos. Docs: cómo detectar un espejo después de mapear.
    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
2026-10-22 pantalla: jugar desde la pantalla táctil (PvP con tablas y vs Magnus)
    La pantalla deja de tener su propio reloj y pasa a manejar la partida real:
    menú → tiempo o dificultad+color → acomodá las piezas → (3, 2, 1) → partida
    → fin, con sensores, LEDs, botones y Stockfish.
    - logica/sesion.py: SesionPvP y SesionMagnus, una partida sin bloquear con
    las fases de la pantalla; el motor corre en su propio hilo. Con tests.
    - Tablas en PvP: PartidaFisica.ofrecer_tablas/responder_tablas (jugar sin
    contestar es rechazar) y Partida.acordar_tablas. Con tests.
    - logica/tablero_simulado.py: jugadas tipeadas como fuente de ocupación,
    para probar la pantalla en la notebook. Con tests.
    - io/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
2026-10-22 leds: sin LED de sacrificio (se quemó), tabla corrida en -1
    La señal de GPIO 12 entra directo al primer LED de las casillas (h8):
    LED_CANTIDAD = 64, LED_INDICE_SACRIFICIO = None y LED_DE_CASILLA con
    cada índice uno menos. mostrar() solo apaga el de sacrificio si existe.
    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
2026-10-22 pantalla: buscar la card DRM del panel por driver, no por índice fijo
    El orden de /dev/dri/cardN cambia entre arranques: hoy el ili9486 quedó
    como card0 y SDL_KMSDRM_DEVICE_INDEX=1 abría la vc4, con el panel en
    blanco. configurar_entorno_sdl() ahora busca en /sys/class/drm la card
    cuyo driver es ili9486. Doc: ese caso y el de baja tensión.
    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
2026-10-23 docs: arranque automático con systemd y estado de las pruebas en la Pi
    - arranque-automatico.md: tablero.service (root, KillSignal=SIGINT, espera del panel),
    paso a paso con verificación antes del reboot; falta probarlo en la Pi.
    - pendiente-pi.md: tachado todo lo de las secciones 0 a 3 (pasó en la Pi); nuevas
    secciones 4 (mapeo final con la estructura pegada) y 5 (arranque automático).
    - menus.md, juego.md, vs-magnus.md y CLAUDE.md: la pantalla y juego.py ya probados.
    Claude-Session: https://claude.ai/code/session_01CFpur61uM7hhTZMYagevUD
2026-10-23 mapeo leds final
